lizard-electronics/LizardBot1_ProjectFiles/README.md

# LizardBot1_ProjectFiles
## [In Development...]
Project Files for LizardBot 1 differential-drive ROS2 robot.
ROS2 development repository: https://github.com/lizard-electronics/lizardbot1
