lizard-electronics/LizardBot1_ProjectFiles/4_Docs/LizardBot1_Diagrams_Electrical-Layout.pdf

## Hardware Controller PCB

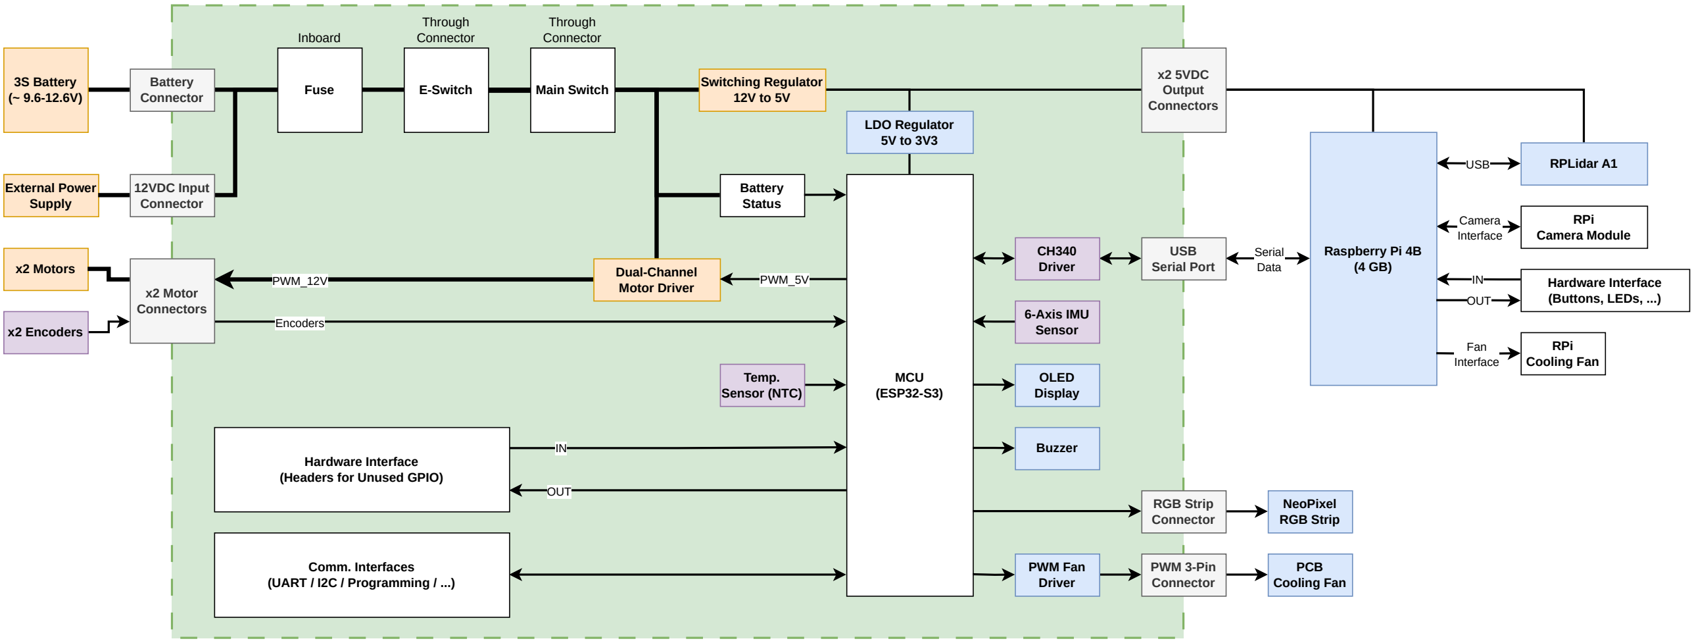
[picture p3: figure]
3S Battery (~ 9.6-12.6V); Switching Regulator; 12V to 5V Fuse; E-Switch; Main Switch; PWM_12V; Dual-Channel Motor Driver; x2 Motors; Encoders; PWM_5V; MCU (ESP32-S3); USB; RPLidar A1; Camera Interface; Raspberry Pi 4B (4 GB); Inboard; Through Connector; Comm. Interfaces (UART / I2C / Programming / ...); OUT; Hardware Interface (Headers for Unused GPIO); RPi Camera Module; Hardware Interface; (Buttons, LEDs, ...); Temp. Sensor (NTC); PCB Cooling Fan; Fan Interface; RPi Cooling Fan; Battery Status; LDO Regulator 5V to 3V3; External Power Supply; x2 Motor Connectors; 12VDC Input Connector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
