lizard-electronics/LizardBot1_ProjectFiles/4_Docs/LizardBot1_ESP32_Pinout.xlsx

Sheet: ESP32_Pinout
PIN | GPIO | INPUT | OUTPUT | ADC | Comments | LizardBot1 Signal Label |  |  | 1 | 38
1 | GND | - | - | - |  |  |  |  | 2 | 37
2 | VDD | - | - | - |  |  |  |  | 3 | 36
3 | EN | - | - | - |  |  |  | MCU_BAT_STATUS | 4 | 35
4 | 36 (VP) | YES | NO | ADC1_0 | Input only GPIO, cannot be configured as output | MCU_BAT_STATUS | ANALOG IN | DRV1_IPROPI | 5 | 34
5 | 39 (VN) | YES | NO | ADC1_3 | Input only GPIO, cannot be configured as output | DRV2_IPROPI | ANALOG IN | DRV1_nFAULT | 6 | 33 | DRV1_nSLEEP
6 | 34 | YES | NO | ADC1_6 | Input only GPIO, cannot be configured as output | DRV1_IPROPI | ANALOG IN | ENC1_A | 7 | 32
7 | 35 | YES | NO | ADC1_7 | Input only GPIO, cannot be configured as output | ENC2_A | ANALOG IN | ENC1_B | 8 | 31 | DRV1_PH_IN2
8 | 32 | YES | YES | ADC1_4 |  | ENC2_B | ANALOG IN | DRV2_IPROPI | 9 | 30 | DRV1_EN_IN1
9 | 33 | YES | YES | ADC1_5 |  | DRV2_nFAULT | ANALOG IN | DRV2_nFAULT | 10 | 29 | MCU_FAN_PWM
10 | 25 | YES | YES | ADC2_8 |  | DRV2_nSLEEP | I/O | ENC2_A | 11 | 28 | DRV2_nSLEEP
11 | 26 | YES | YES | ADC2_9 |  | DRV2_PH_IN2 | I/O | ENC2_B | 12 | 27 | DRV2_PH_IN2
12 | 27 | YES | YES | ADC2_7 |  | DRV2_EN_IN1 | I/O | MCU_BUZZER | 13 | 26 | DRV2_EN_IN1
13 | 14 | YES | YES | ADC2_6 |  | MCU_BUZZER | I/O |  | 14 | 25
14 | 12 (MTDI) | YES (Internal pull-down) | YES | ADC2_5 | Must be LOW during boot | MCU_IO12_RESERVED | O
15 | NC | - | - | -
16 | 13 | YES | YES | ADC2_4 |  | MCU_BUTTON | I/O |  | 1 (GND) | 38 (GND)
17 | 9 (SHD/SD2) | NO | NO | - | Connected to Flash memory |  |  |  | 2 (VDD) | 37 (SCL)
18 | 10 (SWP/SD3) | NO | NO | - | Connected to Flash memory |  |  |  | 3 (EN) | 36 (SDA)
19 | 11 (SCS/CMD) | NO | NO | - | Connected to Flash memory |  |  | MCU_BAT_STATUS | 4 (36) | 35 (TXD)
20 | 6 (SCK/CLK) | NO | NO | - | Connected to Flash memory |  |  | DRV2_IPROPI | 5 (39) | 34 (RXD)
21 | 7 (SDO/SD0) | NO | NO | - | Connected to Flash memory |  |  | DRV1_IPROPI | 6 (34) | 33 (21) | ENC1_B
22 | 8 (SDI/SD1) | NO | NO | - | Connected to Flash memory |  |  | ENC2_A | 7 (35) | 32 (NC)
23 | 15 (MTDO) | YES (Internal pull-up) | YES | ADC2_3 | Must be HIGH during boot, prevents startup log if pulled LOW | MCU_NEOPIXEL | O | ENC2_B | 8 (32) | 31 (19) | ENC1_A
24 | 2 | YES (Internal pull-down) | YES | ADC2_2 | Must be LOW during boot and connected to the on-board LED | MCU_IO2_LED | MCU_IO2_LED | DRV2_nFAULT | 9 (33) | 30 (18) | DRV1_EN_IN1
25 | 0 | YES (Internal pull-up) | YES | ADC2_1 | Must be HIGH during boot and LOW for programming | MCU_IO0 | MCU_IO0 | DRV2_nSLEEP | 10 (25) | 29 (5) | MCU_FAN_PWM
26 | 4 | YES | YES | ADC2_0 |  | DRV1_nFAULT | I/O | DRV2_PH_IN2 | 11 (26) | 28 (17) | DRV1_PH_IN2
27 | 16 | YES | YES | - |  | DRV1_nSLEEP | I/O | DRV2_EN_IN1 | 12 (27) | 27 (16) | DRV1_nSLEEP
28 | 17 | YES | YES | - |  | DRV1_PH_IN2 | I/O | MCU_BUZZER | 13 (14) | 26 (4) | DRV1_nFAULT
29 | 5 | YES | YES | - | Must be HIGH during boot | MCU_FAN_PWM | O |  | 14 (12) | 25 (0)
30 | 18 | YES | YES | - |  | DRV1_EN_IN1 | I/O
31 | 19 | YES | YES | - |  | ENC1_A | I/O
32 | NC | - | - | -
33 | 21 | YES | YES | - |  | ENC1_B | I/O
34 | 3 (RXD0) | YES | NO | - | Rx pin, used for flashing and debugging | MCU_RXD0 | RX
35 | 1 (TXD0) | NO | YES | - | Tx pin, used for flashing and debugging | MCU_TXD0 | TX
36 | 22 | YES | YES | - | I2C Communication | MCU_SDA | I/O
37 | 23 | YES | YES | - | I2C Communication | MCU_SCL | I/O
38 | GND | - | - | -

Sheet: ControlBoard_SignalList
AIN | MCU_BAT_STATUS
OUT | DRV1_EN_IN1
OUT | DRV1_PH_IN2
OUT | DRV1_nSLEEP
AIN | DRV1_IPROPI
IN | DRV1_nFAULT
IN | ENC1_A
IN | ENC1_B
OUT | DRV2_EN_IN1
OUT | DRV2_PH_IN2
OUT | DRV2_nSLEEP
AIN | DRV2_IPROPI
IN | DRV2_nFAULT
IN | ENC2_A
IN | ENC2_B
