lizard-electronics/LizardBot1_ProjectFiles/1_Hardware/PCB/LizardBot1_ControlBoard_v1/pcb_images/LizardBot1_ControlBoard_v1_all-layers2.png

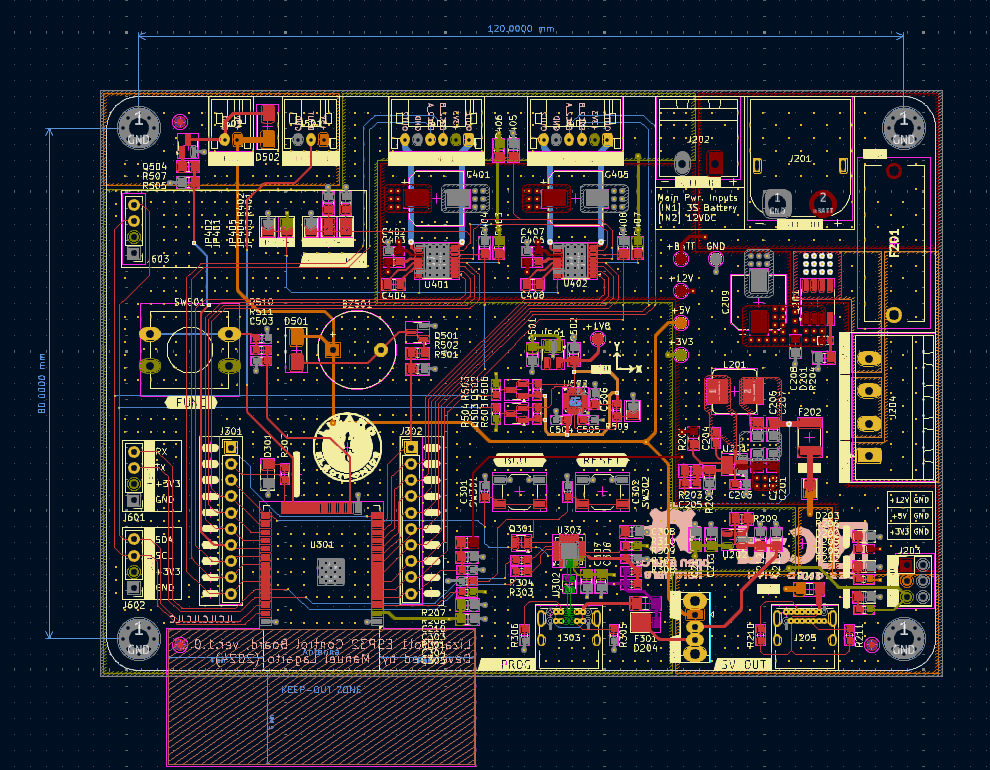
1_Hardware/PCB/LizardBot1_ControlBoard_v1/pcb_images/LizardBot1_ControlBoard_v1_all-layers2.png
