lizard-electronics/LizardBot1_ProjectFiles/1_Hardware/PCB/LizardBot1_ControlBoard_v1/pcb_images/LizardBot1_ControlBoard_v1_b-copper.png

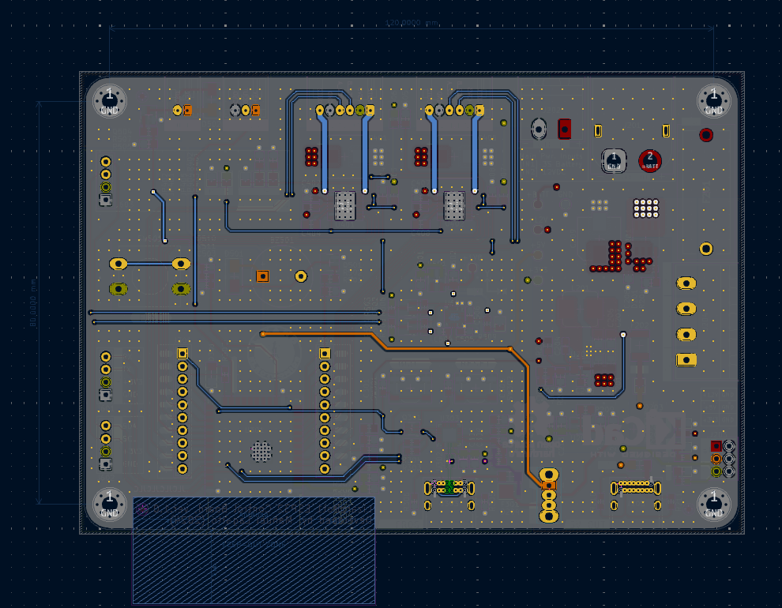
1_Hardware/PCB/LizardBot1_ControlBoard_v1/pcb_images/LizardBot1_ControlBoard_v1_b-copper.png
