lizard-electronics/LizardBot1_ProjectFiles/4_Docs/LizardBot1_ControlBoard_BOM.xlsx

Sheet: BOM
Reference | Value | Datasheet | Footprint | Qty | Part Number | Order | Distribuitor URL | Comments
BZ501 | Buzzer | ~ | Buzzer_Beeper:Buzzer_12x9.5RM7.6 | 1 | C7428406 | YES | https://www.lcsc.com/product-detail/Buzzers_S-S-SEA-12095-0540-42-40P6-5_C7428406.html
C201,C206,C207,C208,C304 | 22uF | ~ | Capacitor_SMD:C_0805_2012Metric_Pad1.18x1.45mm_HandSolder | 5 | C45783 | NO
C202,C212,C305,C307,C308 | 0.1uF | ~ | Capacitor_SMD:C_0805_2012Metric_Pad1.18x1.45mm_HandSolder | 5 | C49678 | NO
C203,C204,C210,C301,C302,C303,C402,C403,C406,C407,C503,C504,C505,C506 | 0.1uF | ~ | Capacitor_SMD:C_0603_1608Metric_Pad1.08x0.95mm_HandSolder | 14 | C14663 | NO
C205 | 33pF | ~ | Capacitor_SMD:C_0603_1608Metric_Pad1.08x0.95mm_HandSolder | 1 | C91368 | YES | https://www.lcsc.com/product-detail/Multilayer-Ceramic-Capacitors-MLCC-SMD-SMT_FH-Guangdong-Fenghua-Advanced-Tech-0603CG330J500NT_C91368.html
C209 | 470uF | ~ | Capacitor_SMD:CP_Elec_8x10 | 1 | C4747956 | YES | https://www.lcsc.com/product-detail/Aluminum-Electrolytic-Capacitors-SMD_KNSCHA-RST470UF25V032_C4747956.html
C211,C213,C214,C306,C501,C502 | 4.7uF | ~ | Capacitor_SMD:C_0805_2012Metric_Pad1.18x1.45mm_HandSolder | 6 | C1779 | NO
C401,C405 | 220uF | ~ | Capacitor_SMD:CP_Elec_8x10 | 2 | C4747976 | YES | https://www.lcsc.com/product-detail/Aluminum-Electrolytic-Capacitors-SMD_KNSCHA-RST220UF35V022_C4747976.html
C404,C408 | 22nF | ~ | Capacitor_SMD:C_0805_2012Metric_Pad1.18x1.45mm_HandSolder | 2 | C51574 | YES | https://www.lcsc.com/product-detail/Multilayer-Ceramic-Capacitors-MLCC-SMD-SMT_FH-Guangdong-Fenghua-Advanced-Tech-0805B223K500NT_C51574.html
D201 | BZT52C12T | https://pt.mouser.com/datasheet/2/115/DIOD_S_A0004048695_1-2542541.pdf | Diode_SMD:D_SOD-523 | 1 | C507911 | YES | https://www.lcsc.com/product-detail/Zener-Diodes_Diodes-Incorporated-BZT52C12T-7_C507911.html
D202,D203,D205 | Green | ~ | LED_SMD:LED_0805_2012Metric_Pad1.15x1.40mm_HandSolder | 3 | C965815 | NO
D204 | SS1P3L | https://www.vishay.com/docs/88915/ss1p3l.pdf | Diode_SMD:D_SMP_DO-220AA | 1 | C2875475 | YES | https://www.lcsc.com/product-detail/Schottky-Diodes_Vishay-Intertech-SS1P3L-M3-84A_C2875475.html
D301 | Red | ~ | LED_SMD:LED_1206_3216Metric_Pad1.42x1.75mm_HandSolder | 1 | C499461 | NO
D501,D502 | SS14 | https://www.vishay.com/docs/88746/ss12.pdf | Diode_SMD:D_SMA | 2 | C2480 | NO
F201 | 10A | https://pt.mouser.com/datasheet/2/240/media-3322743.pdf | Fuse:Fuseholder_Clip-5x20mm_Littelfuse_519_Inline_P20.60x5.00mm_D1.00mm_Horizontal | 1 | C2760101 | YES | https://www.lcsc.com/product-detail/Fuseholders_Littelfuse-0PTF0078P_C2760101.html | No stock at LCSC. Mouser: 576-0PTF0078P
F201-1 |  |  | - |  | C5299837 |  | https://www.lcsc.com/product-detail/Fuseholders_Littelfuse-00BS0232P_C5299837.html | Low stock at LCSC. Mouser: 576-00BS0232P
F201-2 |  |  | - |  | C3166596 |  | https://www.lcsc.com/product-detail/Fuses_Littelfuse-0234010-MXP_C3166596.html | No stock at LCSC. Mouser: 0234010.MXP
F202 | 5A | https://pt.mouser.com/datasheet/2/240/media-3323076.pdf | Fuse:Fuse_1812_4532Metric_Pad1.30x3.40mm_HandSolder | 1 | C127824 | YES | https://www.lcsc.com/product-detail/Resettable-Fuses_Littelfuse-1812L300MR_C127824.html
F203 | 3A | https://pt.mouser.com/datasheet/2/240/media-3319932.pdf | Fuse:Fuse_1206_3216Metric_Pad1.42x1.75mm_HandSolder | 1 | C118413 | YES | https://www.lcsc.com/product-detail/Resettable-Fuses_Littelfuse-1206L150THWR_C118413.html
F301 | 500mA | ~ | Fuse:Fuse_1206_3216Metric_Pad1.42x1.75mm_HandSolder | 1 | C163512 | NO
J201 | XT60PW-M | https://www.lcsc.com/datasheet/lcsc_datasheet_1810251322_Changzhou-Amass-Elec-XT60_C98733.pdf | Connector_AMASS:AMASS_XT60PW-M_1x02_P7.20mm_Horizontal | 1 | C98732 | YES | https://www.lcsc.com/product-detail/plug_Changzhou-Amass-Elec-XT60PW-M_C98732.html
J202 | WJ2EDGR-5.08-2P | https://www.lcsc.com/datasheet/lcsc_datasheet_1912251632_Ningbo-Kangnex-Elec-WJ2EDGR-5-08-2P_C8383.pdf | Connector_Phoenix_MSTB:PhoenixContact_MSTBA_2,5_2-G-5,08_1x02_P5.08mm_Horizontal | 1 | C8383 | YES | https://www.lcsc.com/product-detail/Pluggable-System-Terminal-Block_Ningbo-Kangnex-Elec-WJ2EDGR-5-08-2P_C8383.html
J202-1 | WJ2EDGK-5.08-2P |  | - |  | C71370 |  | https://www.lcsc.com/product-detail/Pluggable-System-Terminal-Block_Ningbo-Kangnex-Elec-WJ2EDGK-5-08-2P_C71370.html
J203 | 2.54mm 2x3 (M) |  | Connector_PinHeader_2.54mm:PinHeader_2x03_P2.54mm_Vertical |  | C65114 | NO
J502 | JST-S2B-PH-K-S(LF)(SN) | ~ | Connector_JST:JST_PH_S2B-PH-K_1x02_P2.00mm_Horizontal | 1 | C173752 | YES | https://www.lcsc.com/product-detail/Wire-To-Board-Connector_JST-S2B-PH-K-S-LF-SN_C173752.html
J502-1 | JST-PHR-2 |  | - |  | C3195190 |  | https://www.lcsc.com/product-detail/Housings-Wire-To-Board-Wire-To-Wire_JST-PHR-2_C3195190.html
J205 | WJ2EDGR-5.08-4P | https://www.lcsc.com/datasheet/lcsc_datasheet_2304140030_Ningbo-Kangnex-Elec-WJ2EDGR-5-08-4P_C8443.pdf | Connector_Phoenix_MSTB:PhoenixContact_MSTBA_2,5_4-G-5,08_1x04_P5.08mm_Horizontal | 1 | C8443 | YES | https://www.lcsc.com/product-detail/Pluggable-System-Terminal-Block_Ningbo-Kangnex-Elec-WJ2EDGR-5-08-4P_C8443.html
J205-1 | WJ2EDGK-5.08-4P |  | - |  | C71372 |  | https://www.lcsc.com/product-detail/Pluggable-System-Terminal-Block_Ningbo-Kangnex-Elec-WJ2EDGK-5-08-4P_C71372.html
J207 | USB_C_Receptacle_PowerOnly_6P | https://www.usb.org/sites/default/files/documents/usb_type-c.zip | Connector_USB:USB_C_Receptacle_GCT_USB4085 | 1 | C7095263 | YES | https://www.lcsc.com/product-detail/span-style-background-color-ff0-USB-span-Connectors_Global-Connector-Technology-USB4085-GF-A_C7095263.html | No stock at LCSC. Mouser: 640-USB4085-GF-A
J301,J302 | 2.54mm (F) | ~ | Connector_PinHeader_2.54mm:PinHeader_1x10_P2.54mm_Vertical | 2 | NA | NO
J303 | USB_C_Receptacle_USB2.0_16P | https://www.usb.org/sites/default/files/documents/usb_type-c.zip | Connector_USB:USB_C_Receptacle_GCT_USB4085 | 1 | C7095263 | YES | https://www.lcsc.com/product-detail/span-style-background-color-ff0-USB-span-Connectors_Global-Connector-Technology-USB4085-GF-A_C7095263.html | No stock at LCSC. Mouser: 640-USB4085-GF-A
J401,J402 | JST-S6B-PH-K-S(LF)(SN) | ~ | Connector_JST:JST_PH_S6B-PH-K_1x06_P2.00mm_Horizontal | 2 | C157920 | NO
J501 | JST-S3B-PH-K-S(LF)(SN) | ~ | Connector_JST:JST_PH_S3B-PH-K_1x03_P2.00mm_Horizontal | 1 | C157929 | YES | https://www.lcsc.com/product-detail/Wire-To-Board-Connector_JST-S3B-PH-K-S-LF-SN_C157929.html
J501-1 | JST-PHR-3 |  | - |  | C265393 |  | https://www.lcsc.com/product-detail/Housings-Wire-To-Board-Wire-To-Wire_JST-PHR-3_C265393.html
J601,J602,J603 | 2.54mm (F) | ~ | Connector_PinHeader_2.54mm:PinHeader_1x04_P2.54mm_Vertical | 3 | NA | NO
L201 | 4.7uH | https://pt.mouser.com/datasheet/2/54/BOURNS_SRP7028AA-2064300.pdf | Inductor_SMD:L_Bourns_SRP7028A_7.3x6.6mm | 1 | C840529 | YES | https://www.lcsc.com/product-detail/Power-Inductors_BOURNS-SRP7028A-4R7M_C840529.html
Q201 | SQ4425EY | https://ngspice.sourceforge.io/docs/ngspice-html-manual/manual.xhtml#cha_MOSFETs | Package_SO:SO-8_3.9x4.9mm_P1.27mm | 1 | C6495636 | YES | https://www.lcsc.com/product-detail/MOSFETs_Vishay-Intertech-SQ4425EY-T1_GE3_C6495636.html
Q301 | UMH3N | http://rohmfs.rohm.com/en/products/databook/datasheet/discrete/transistor/digital/emh3t2r-e.pdf | Package_TO_SOT_SMD:SOT-363_SC-70-6 | 1 | C123008 | YES | https://www.lcsc.com/product-detail/Digital-Transistors_ROHM-Semicon-UMH3NTN_C123008.html
Q501,Q504 | AO3400A | http://www.aosmd.com/pdfs/datasheet/AO3400A.pdf | Package_TO_SOT_SMD:SOT-23 | 2 | C700953 | NO
Q502,Q503 | BSS138 | https://www.onsemi.com/pub/Collateral/BSS138-D.PDF | Package_TO_SOT_SMD:SOT-23 | 2 | C7420339 | YES | https://www.lcsc.com/product-detail/MOSFETs_hongjiacheng-BSS138_C7420339.html
R201,R209 | 100k | ~ | Resistor_SMD:R_0805_2012Metric_Pad1.20x1.40mm_HandSolder | 2 | C149504 | NO
R202 | 5.49k | ~ | Resistor_SMD:R_0805_2012Metric_Pad1.20x1.40mm_HandSolder | 1 | C17726 | YES | https://www.lcsc.com/product-detail/Chip-Resistor-Surface-Mount_UNI-ROYAL-Uniroyal-Elec-0805W8F5491T5E_C17726.html
R203 | 40.2k | ~ | Resistor_SMD:R_0805_2012Metric_Pad1.20x1.40mm_HandSolder | 1 | C17678 | YES | https://www.lcsc.com/product-detail/Chip-Resistor-Surface-Mount_UNI-ROYAL-Uniroyal-Elec-0805W8F4022T5E_C17678.html
R204,R207,R403,R407,R501,R505 | 10k | ~ | Resistor_SMD:R_0805_2012Metric_Pad1.20x1.40mm_HandSolder | 6 | C17414 | YES | https://www.lcsc.com/product-detail/Chip-Resistor-Surface-Mount_UNI-ROYAL-Uniroyal-Elec-0805W8F1002T5E_C17414.html
R205,R206,R302,R310 | 1k | ~ | Resistor_SMD:R_0603_1608Metric_Pad0.98x0.95mm_HandSolder | 4 | C2907002 | NO
R208 | 3.3k | ~ | Resistor_SMD:R_0805_2012Metric_Pad1.20x1.40mm_HandSolder | 1 | C26010 | YES | https://www.lcsc.com/product-detail/Chip-Resistor-Surface-Mount_UNI-ROYAL-Uniroyal-Elec-0805W8F3301T5E_C26010.html
R210,R211,R301,R503,R504,R506,R508,R509,R510 | 10k | ~ | Resistor_SMD:R_0603_1608Metric_Pad0.98x0.95mm_HandSolder | 9 | C98220 | NO
R212,R511 | 470 | ~ | Resistor_SMD:R_0603_1608Metric_Pad0.98x0.95mm_HandSolder | 2 | C2907041 | NO
R305,R306 | 5k1 | ~ | Resistor_SMD:R_0603_1608Metric_Pad0.98x0.95mm_HandSolder | 2 | C23186 | YES | https://www.lcsc.com/product-detail/Chip-Resistor-Surface-Mount_UNI-ROYAL-Uniroyal-Elec-0603WAF5101T5E_C23186.html
R307,R308,R309 | 47k | ~ | Resistor_SMD:R_0603_1608Metric_Pad0.98x0.95mm_HandSolder | 3 | C2907042 | NO
R401 | 62k | ~ | Resistor_SMD:R_0805_2012Metric_Pad1.20x1.40mm_HandSolder | 1 | C17783 | YES | https://www.lcsc.com/product-detail/Chip-Resistor-Surface-Mount_UNI-ROYAL-Uniroyal-Elec-0805W8F6202T5E_C17783.html
R402 | 20k | ~ | Resistor_SMD:R_0805_2012Metric_Pad1.20x1.40mm_HandSolder | 1 | C2907240 | NO
R404,R408 | 1.2k | ~ | Resistor_SMD:R_0805_2012Metric_Pad1.20x1.40mm_HandSolder | 2 | C17379 | YES | https://www.lcsc.com/product-detail/Chip-Resistor-Surface-Mount_UNI-ROYAL-Uniroyal-Elec-0805W8F1201T5E_C17379.html
R405 | 16k | ~ | Resistor_SMD:R_0805_2012Metric_Pad1.20x1.40mm_HandSolder | 1 | C17490 | YES | https://www.lcsc.com/product-detail/Chip-Resistor-Surface-Mount_UNI-ROYAL-Uniroyal-Elec-0805W8F1602T5E_C17490.html
R406 | 50k | ~ | Resistor_SMD:R_0805_2012Metric_Pad1.20x1.40mm_HandSolder | 1 | C2828840 | YES | https://www.lcsc.com/product-detail/Chip-Resistor-Surface-Mount_Viking-Tech-ARG05DTC5002_C2828840.html
R502,R507 | 150 | ~ | Resistor_SMD:R_0805_2012Metric_Pad1.20x1.40mm_HandSolder | 2 | C17471 | NO
SW201 | SW_SPDT | ~ | Button_Switch_THT:SW_Slide_SPDT_Straight_CK_OS102011MS2Q | 1 | C2800116 | NO
SW301,SW302 | SW_Push | ~ | Button_Switch_SMD:SW_SPST_TL3342 | 2 | C2886894 | NO
SW501 | SW_Push | ~ | Button_Switch_THT:SW_PUSH-12mm | 1 | C455206 | NO
U201 | MP2225 | https://www.monolithicpower.com/en/documentview/productdocument/index/version/2/document_type/Datasheet/lang/en/sku/MP2225GJ-Z | Package_TO_SOT_SMD:SOT-23-8 | 1 | 946-MP2225GJ-Z | YES | https://pt.mouser.com/ProductDetail/Monolithic-Power-Systems-MPS/MP2225GJ-Z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 | Discontinued at LCSC! Mouser: 946-MP2225GJ-Z
U202 | AP2112K-3.3 | https://www.diodes.com/assets/Datasheets/AP2112.pdf | Package_TO_SOT_SMD:SOT-23-5 | 1 | C51118 | YES | https://www.lcsc.com/product-detail/Voltage-Regulators-Linear-Low-Drop-Out-LDO-Regulators_Diodes-Incorporated-AP2112K-3-3TRG1_C51118.html
U301 | ESP32-WROOM-32E | https://www.espressif.com/sites/default/files/documentation/esp32-wroom-32e_esp32-wroom-32ue_datasheet_en.pdf | RF_Module:ESP32-WROOM-32D | 1 | 356-ESP32WRM32E164PH | YES | https://pt.mouser.com/ProductDetail/Espressif-Systems/ESP32-WROOM-32E-N8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 | More expensive from LCSC. Order from Mouser: 356-ESP32WRM32E164PH
U302 | USBLC6-2P6 | https://www.st.com/resource/en/datasheet/usblc6-2.pdf | Package_TO_SOT_SMD:SOT-666 | 1 | C2827693 | YES | https://www.lcsc.com/product-detail/ESD-and-Surge-Protection-TVS-ESD_TECH-PUBLIC-USBLC6-2P6_C2827693.html
U303 | CP2102N-Axx-xQFN24 | https://www.silabs.com/documents/public/data-sheets/cp2102n-datasheet.pdf | Package_DFN_QFN:QFN-24-1EP_4x4mm_P0.5mm_EP2.6x2.6mm | 1 | C969151 | YES | https://www.lcsc.com/product-detail/USB-Converters_SKYWORKS-SILICON-LABS-CP2102N-A02-GQFN24R_C969151.html | Order in PCBA
U401,U402 | DRV8874 | https://www.ti.com/lit/ds/symlink/drv8874.pdf?ts=1718834450917 | Package_SO:HTSSOP-16-1EP_4.4x5mm_P0.65mm_EP3.4x5mm_Mask3x3mm_ThermalVias | 2 | C1855818 | YES | https://www.lcsc.com/product-detail/Brushed-DC-Motor-Drivers_Texas-Instruments-DRV8874PWPR_C1855818.html
U501 | MIC5225 | https://pt.mouser.com/datasheet/2/268/MIC5225_Ultra_Low_Quiescent_Current_150mA_MicroCap-3441824.pdf | Package_TO_SOT_SMD:SOT-23-5_HandSoldering | 1 | C510894 | YES | https://www.lcsc.com/product-detail/Voltage-Regulators-Linear-Low-Drop-Out-LDO-Regulators_Microchip-Tech-MIC5225-3-0YM5-TR_C510894.html | No stock at LCSC. Mouser: 998-MIC5225-1.8YM5TR
U502 | ICM-20948 | http://www.invensense.com/wp-content/uploads/2016/06/DS-000189-ICM-20948-v1.3.pdf | Sensor_Motion:InvenSense_QFN-24_3x3mm_P0.4mm | 1 | C726001 | YES | https://www.lcsc.com/product-detail/Attitude-Sensors-Gyroscope_TDK-InvenSense-ICM-20948_C726001.html | Order in PCBA
Total: |  |  |  | 122

Sheet: Quote
Store | Products | Price | Order | Comments | Total | 350.30 €
JLCPCB | PCB & Assembly | 105.51 € | 2024-08-09 | Arrival in 12-15 business days. | Original Balance | 3253.95 €
LCSC | PCB Parts | 43.72 € | 2024-08-09 | Arrival in 7-15 business days. | Balance | 2903.65 €
Mouser | PCB Parts & Lidar & Raspberry Kit | 102.14 € | 2024-08-16 | Arrival in 2-3 business days.
Mauser | Raspberry Pi 4B 4GB Kit | 77.91 € | 2024-08-16 | Arrival in 2-3 business days.
Amazon | Motors | 21.02 € | 2024-08-16 | Arrival in 2-3 business days.
 | Battery & Charger
