lizard-electronics/LizardBot1_ProjectFiles/1_Hardware/PCB/LizardBot1_ControlBoard_v1/Project_3DModels/Bourns_SRP7028AA.STEP

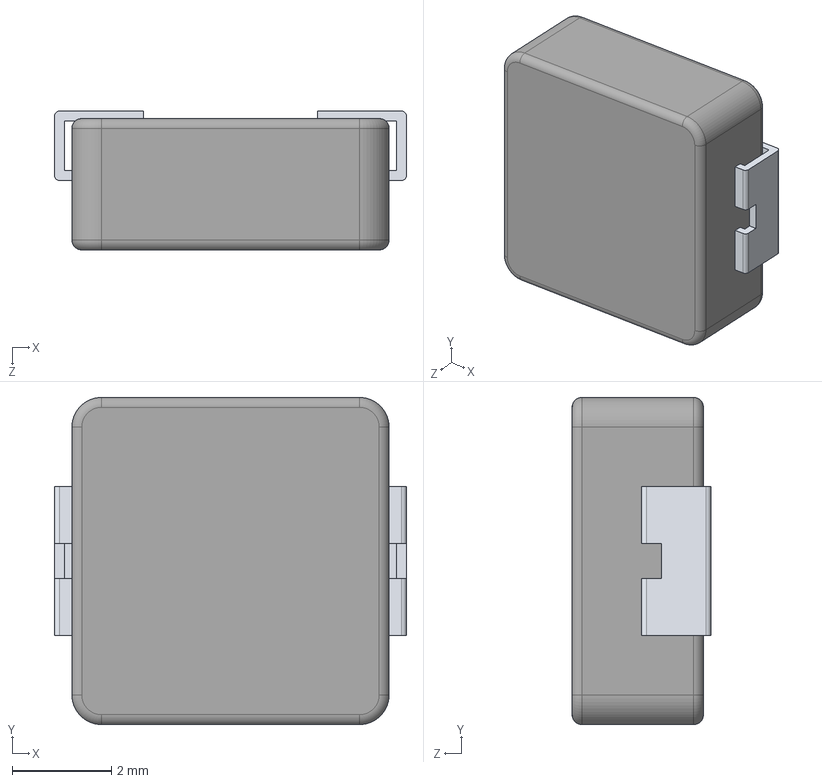
[picture p12: CAD file, 2024-07-31]
1_Hardware/PCB/LizardBot1_ControlBoard_v1/Project_3DModels/Bourns_SRP7028AA.STEP
7.10 x 6.60 x 2.80 mm
Body.STEP
Pin1.STEP
Pin2.STEP
