lizard-electronics/LizardBot1_ProjectFiles/1_Hardware/PCB/LizardBot1_ControlBoard_v1/Project_3DModels/XT60PW-M.STEP

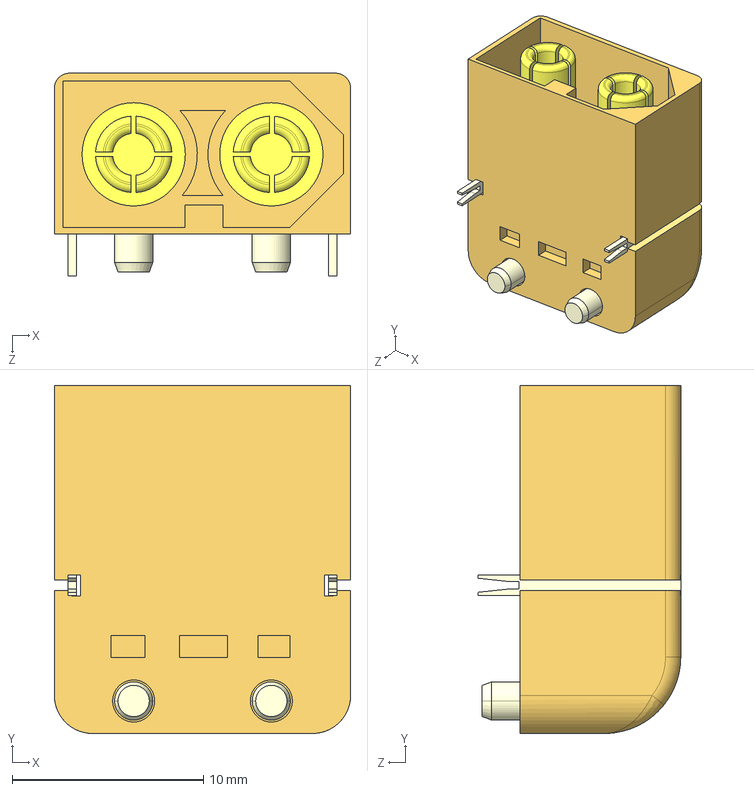
[picture p13: CAD file, 2024-07-31]
1_Hardware/PCB/LizardBot1_ControlBoard_v1/Project_3DModels/XT60PW-M.STEP
15.5 x 18.2 x 10.6 mm
