lizard-electronics/LizardBot1_ProjectFiles/1_Hardware/PCB/LizardBot1_ControlBoard_v1/Project_3DModels/LittelFuse_0PTF0078P.stp

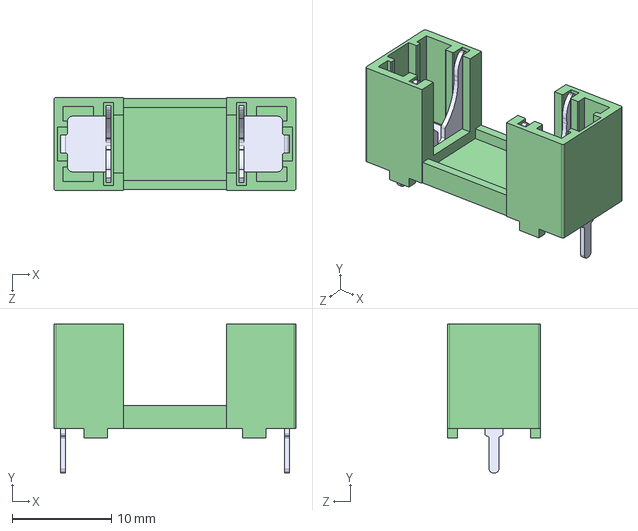
[picture p14: CAD file, 2024-07-31]
1_Hardware/PCB/LizardBot1_ControlBoard_v1/Project_3DModels/LittelFuse_0PTF0078P.stp
24.4 x 15.0 x 9.40 mm
