lizard-electronics/LizardBot1_ProjectFiles/1_Hardware/PCB/LizardBot1_ControlBoard_v1/Project_3DModels/SW_Push_12mm.STEP

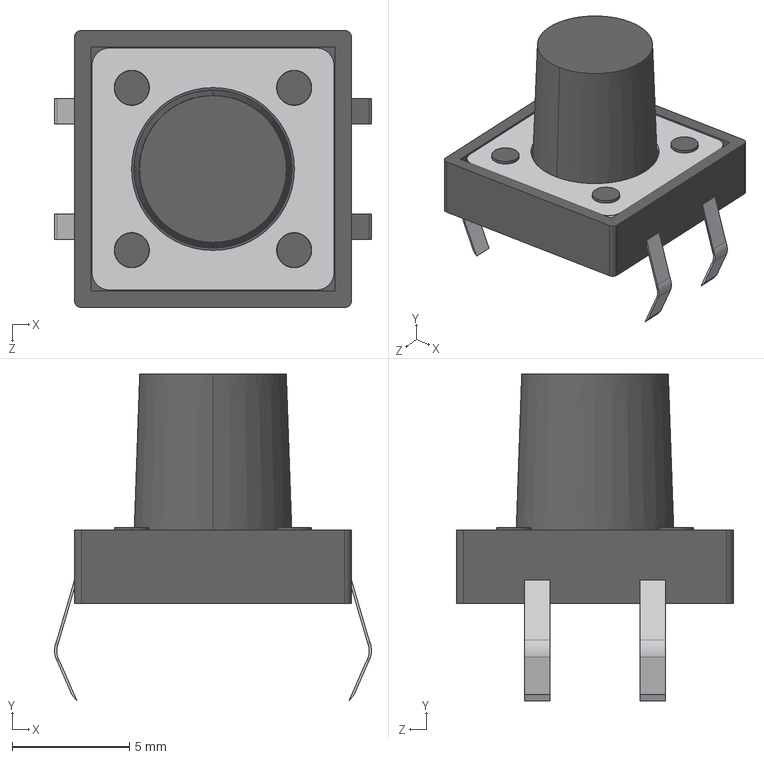
[picture p15: CAD file, 2024-07-31]
1_Hardware/PCB/LizardBot1_ControlBoard_v1/Project_3DModels/SW_Push_12mm.STEP
13.5 x 14.0 x 11.8 mm
