lizard-electronics/LizardBot1_ProjectFiles/1_Hardware/PCB/LizardBot1_ControlBoard_v1/Project_3DModels/Fuse_1812.STEP

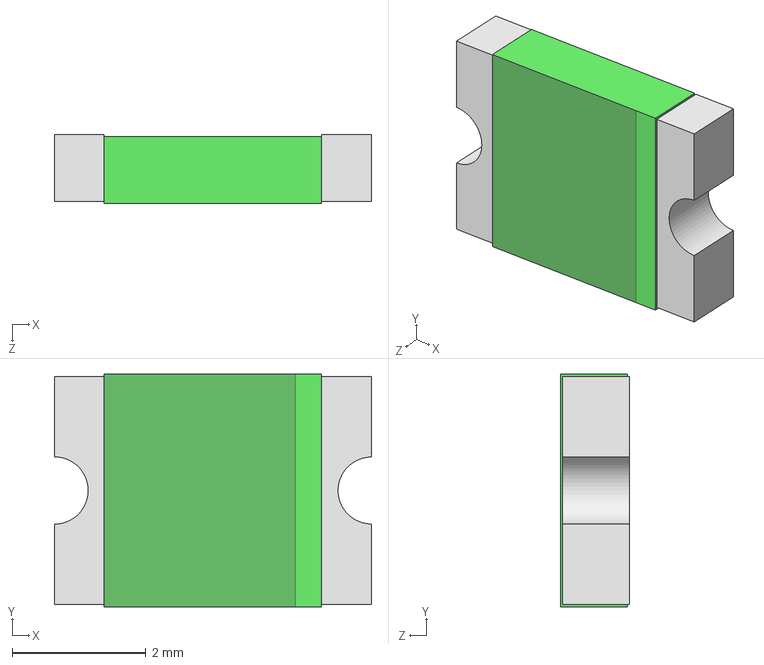
[picture p16: CAD file, 2024-07-31]
1_Hardware/PCB/LizardBot1_ControlBoard_v1/Project_3DModels/Fuse_1812.STEP
4.74 x 3.48 x 1.04 mm
