lizard-electronics/LizardBot1_ProjectFiles/1_Hardware/LizardBot1_ControlBoard_Schematic_v1.pdf

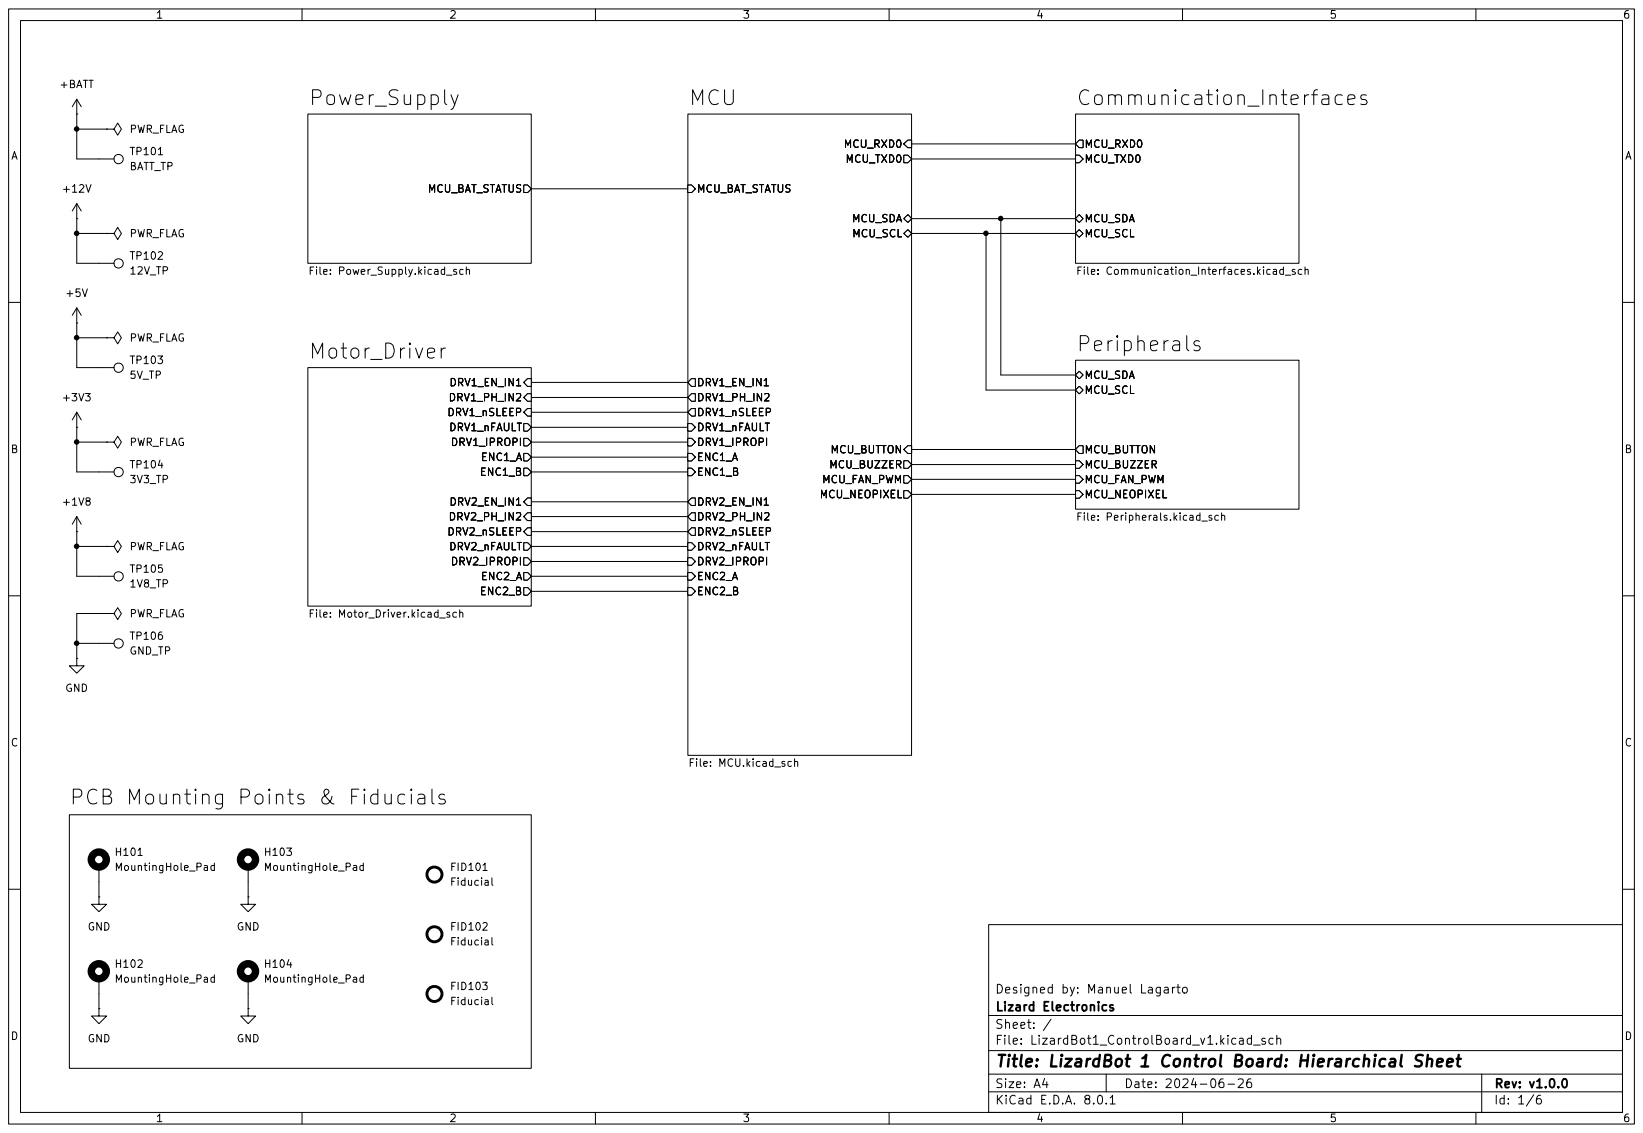
[picture p17: page 1]

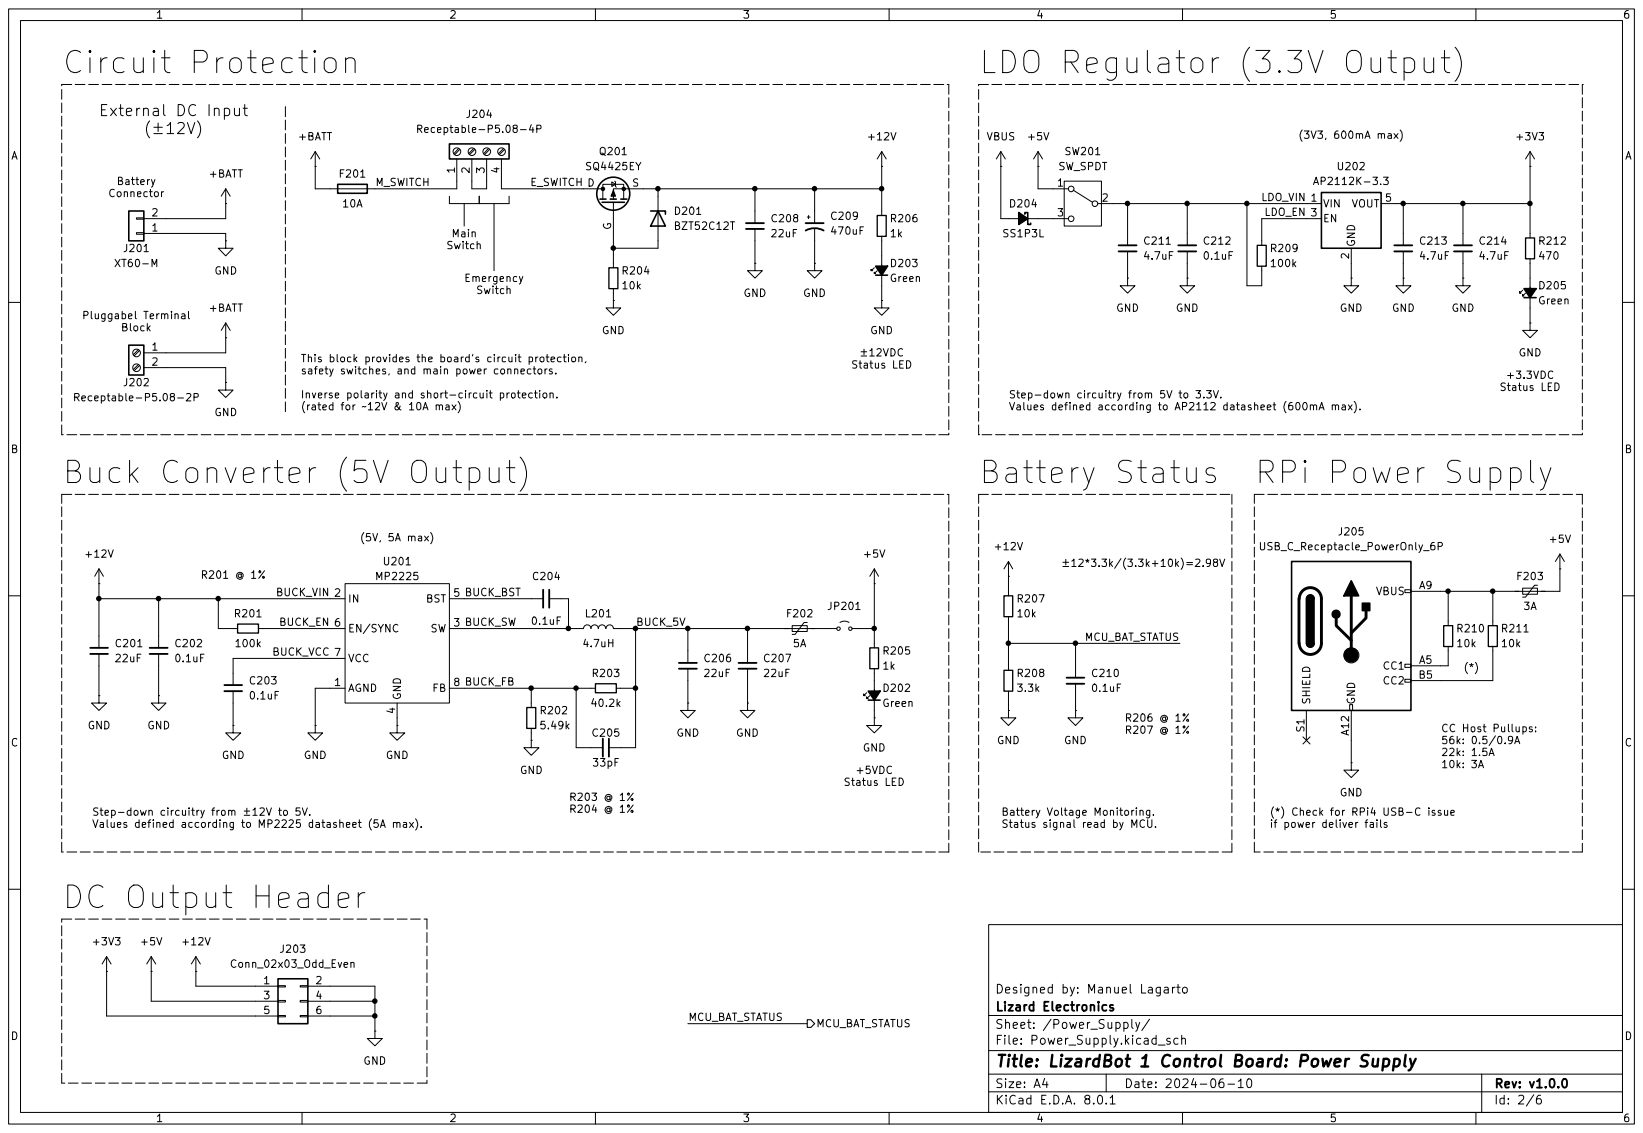
[picture p18: page 2]

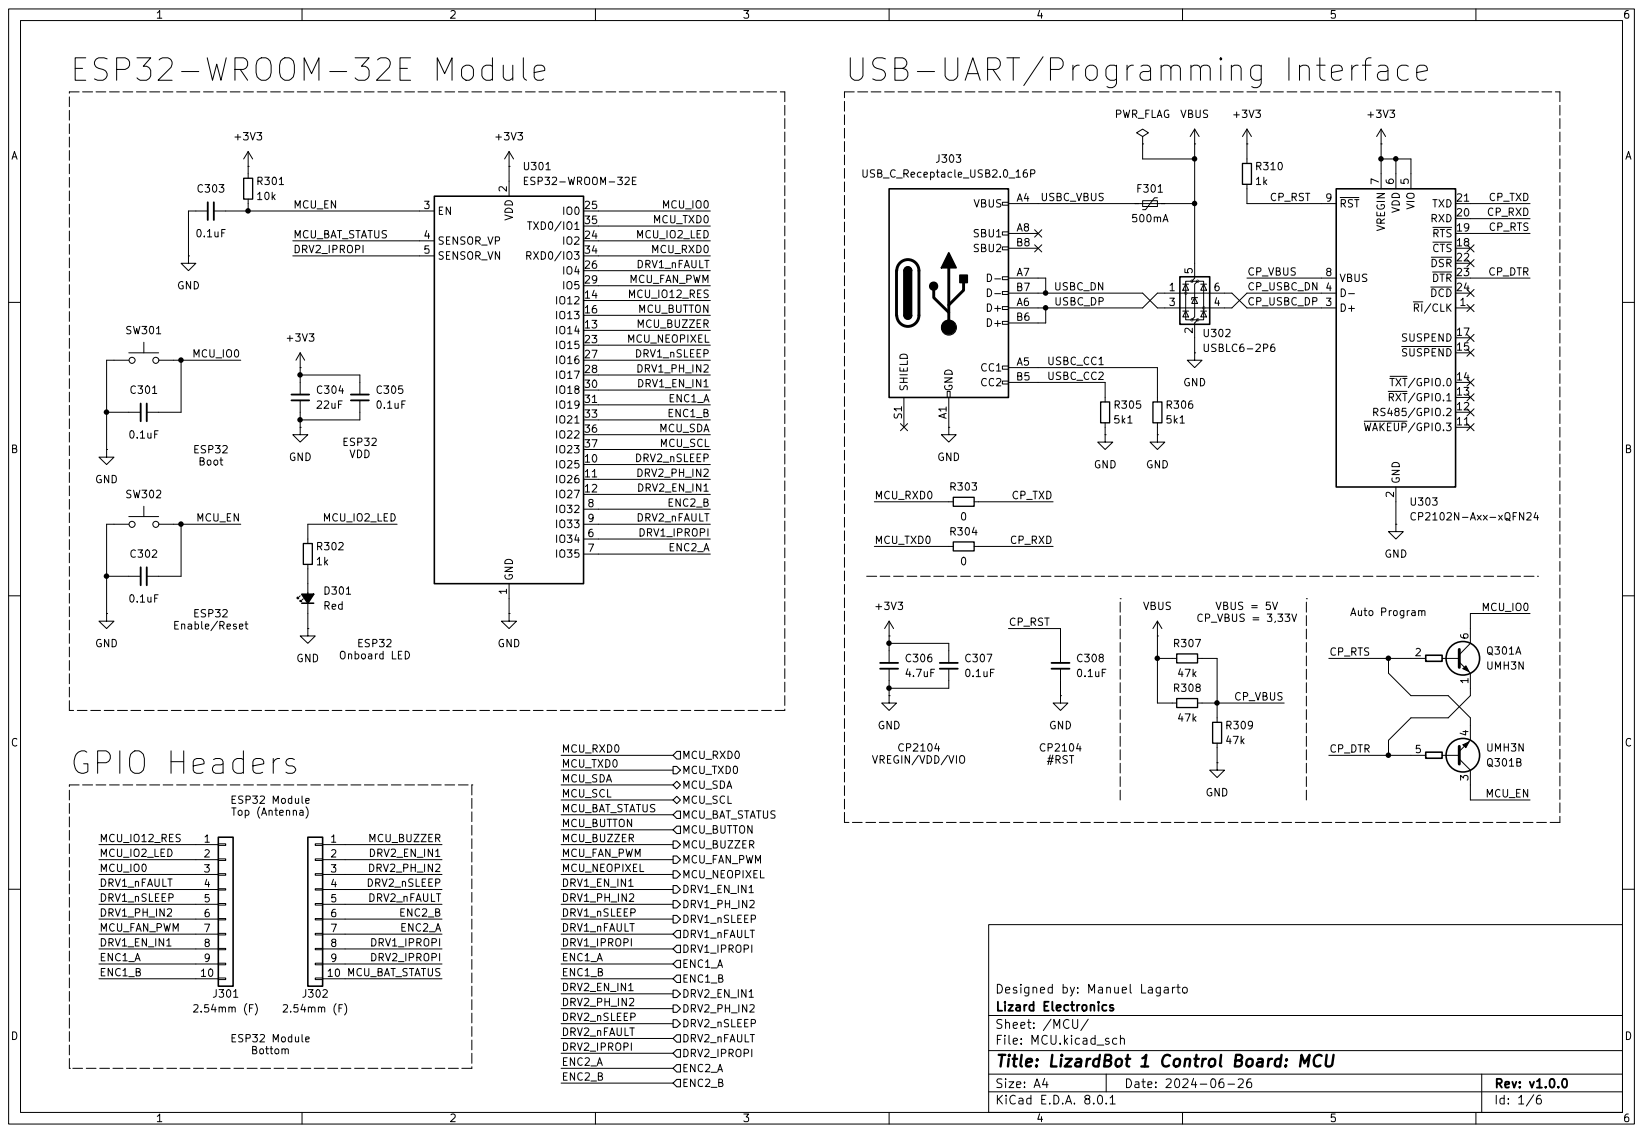
[picture p19: page 3]

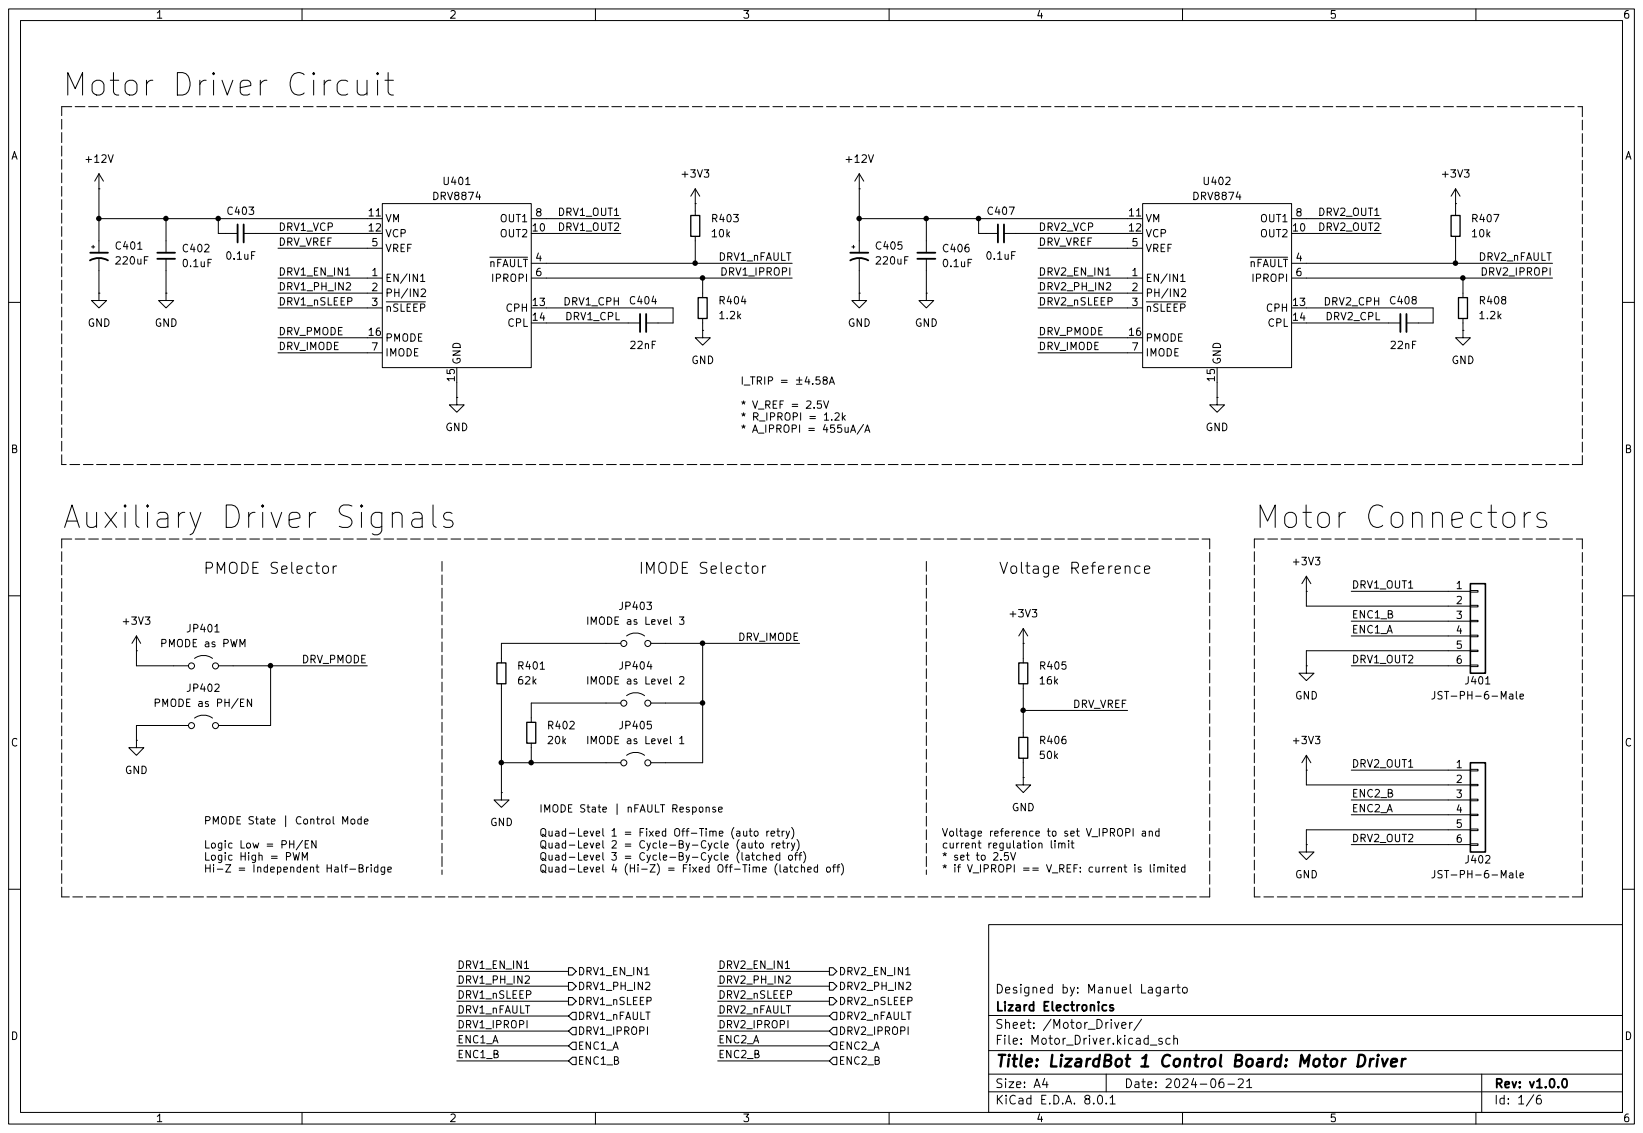
[picture p20: page 4]

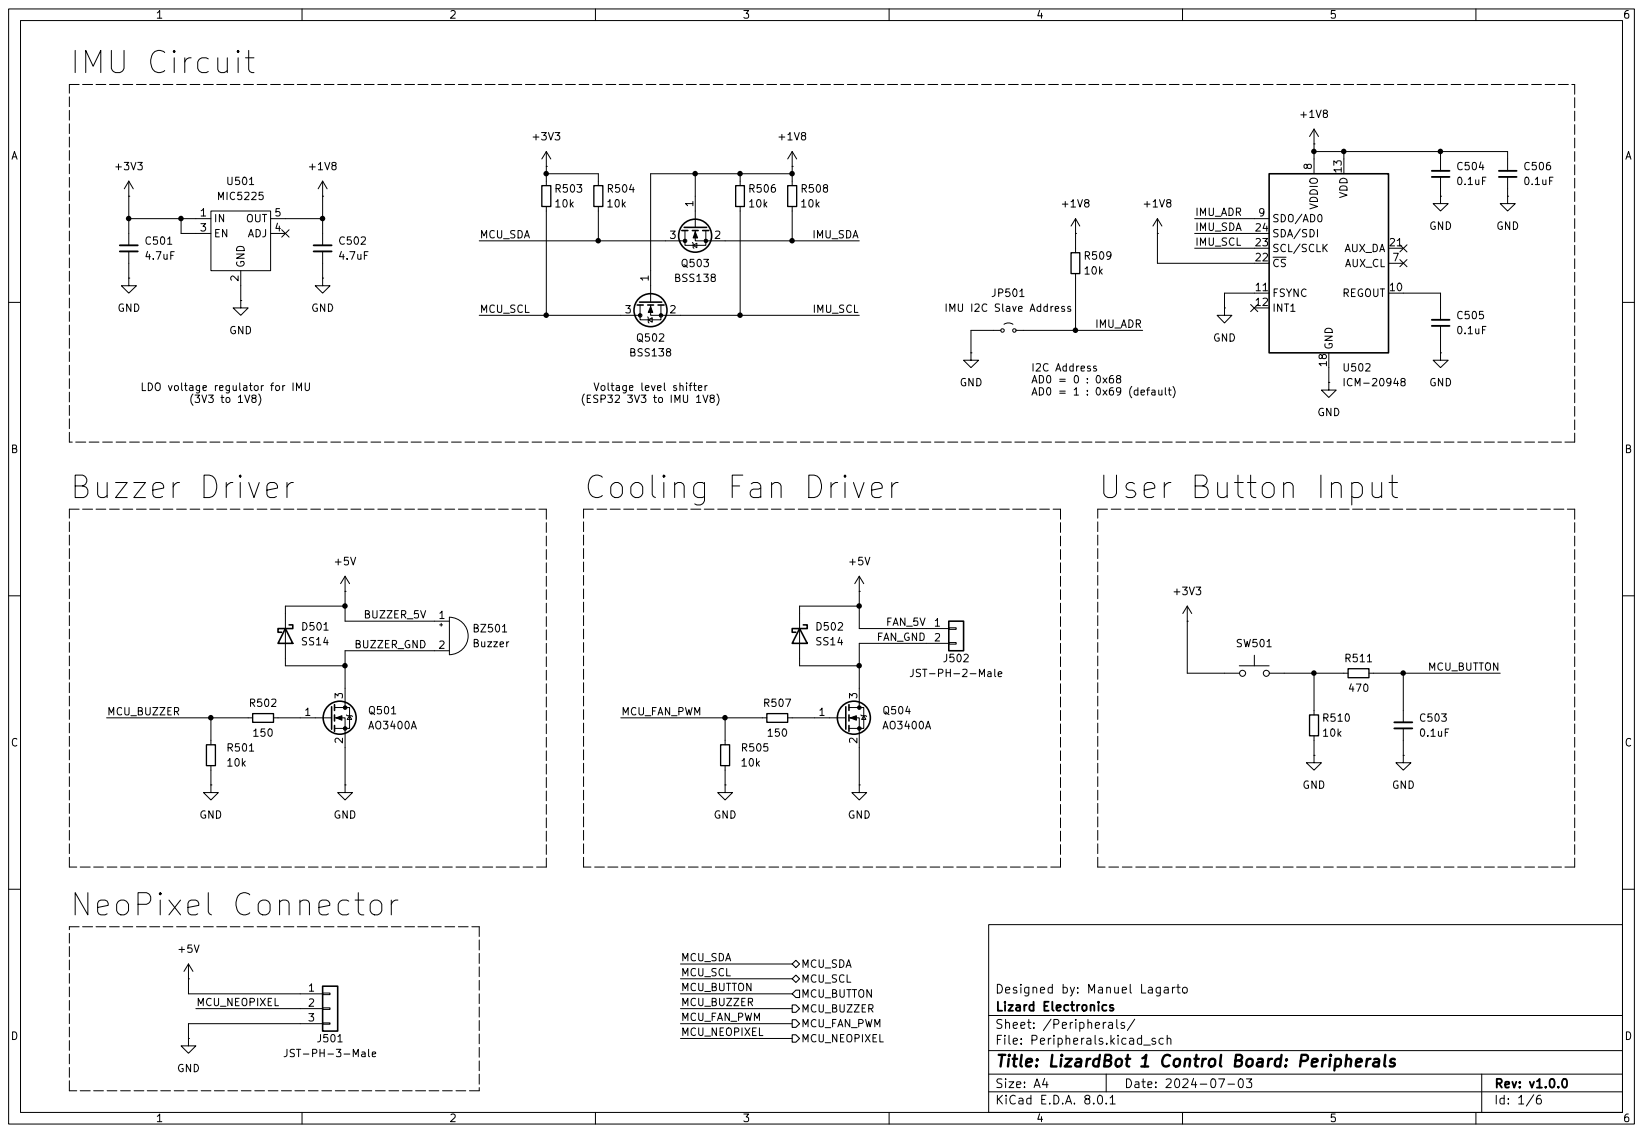
[picture p21: page 5]

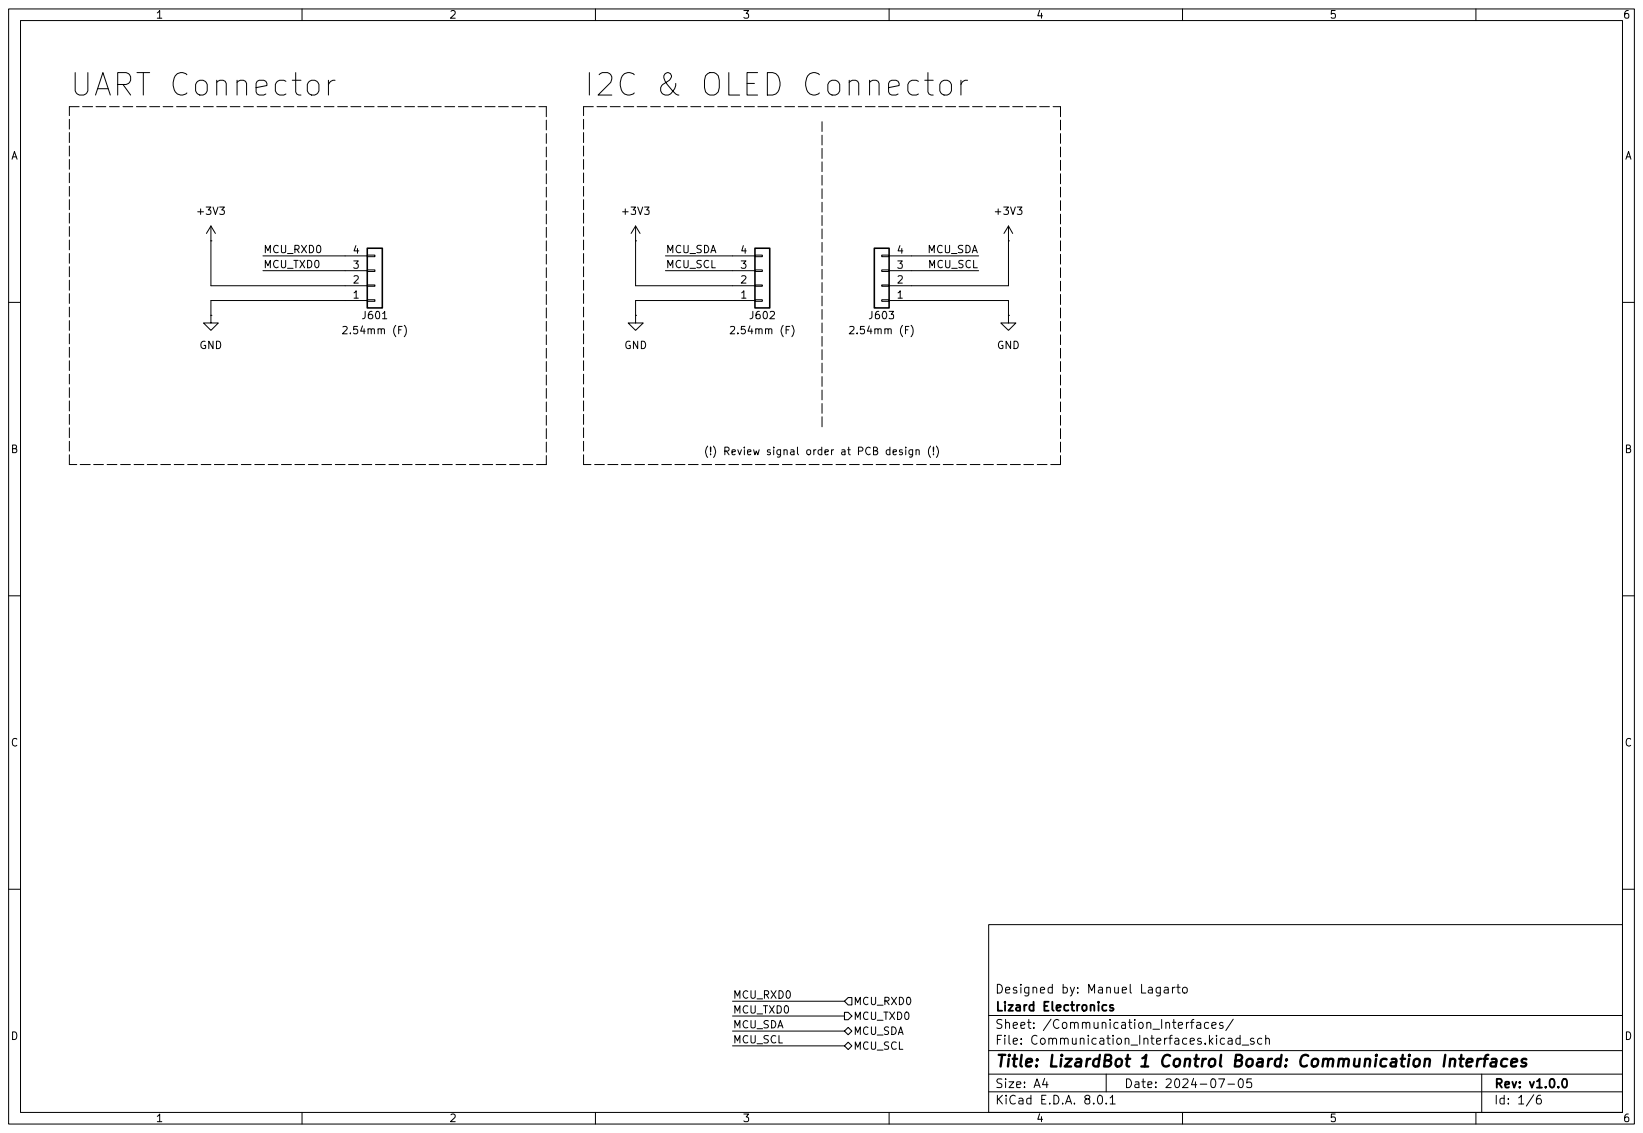
[picture p22: page 6]
