lizard-electronics/LizardBot1_ProjectFiles/1_Hardware/SPICE/LizardBot1_ControlBoard_SPICE_CircuitProtection.asc

C1: cap; 22µ; V=35 Irms=1.63 Rser=0.07 Lser=0 mfg="Vishay" pn="T55V226M035" type="Tantalum Polymer"
D1: zener; BZX84C12L
M1: pmos; AO4630_P
R1: res; 1k
R2: res; 4
V1: voltage; 12
Named nets: 0
.tran 0 1 0 0.1
.dc V1 -12 12 0.5
