lizard-electronics/LizardBot1_ProjectFiles/1_Hardware/PCB/LizardBot1_ControlBoard_v1/LizardBot1_ControlBoard_v1.kicad_pcb

## KiCad design 1_Hardware/PCB/LizardBot1_ControlBoard_v1/LizardBot1_ControlBoard_v1.kicad_pcb (2024-07-31)

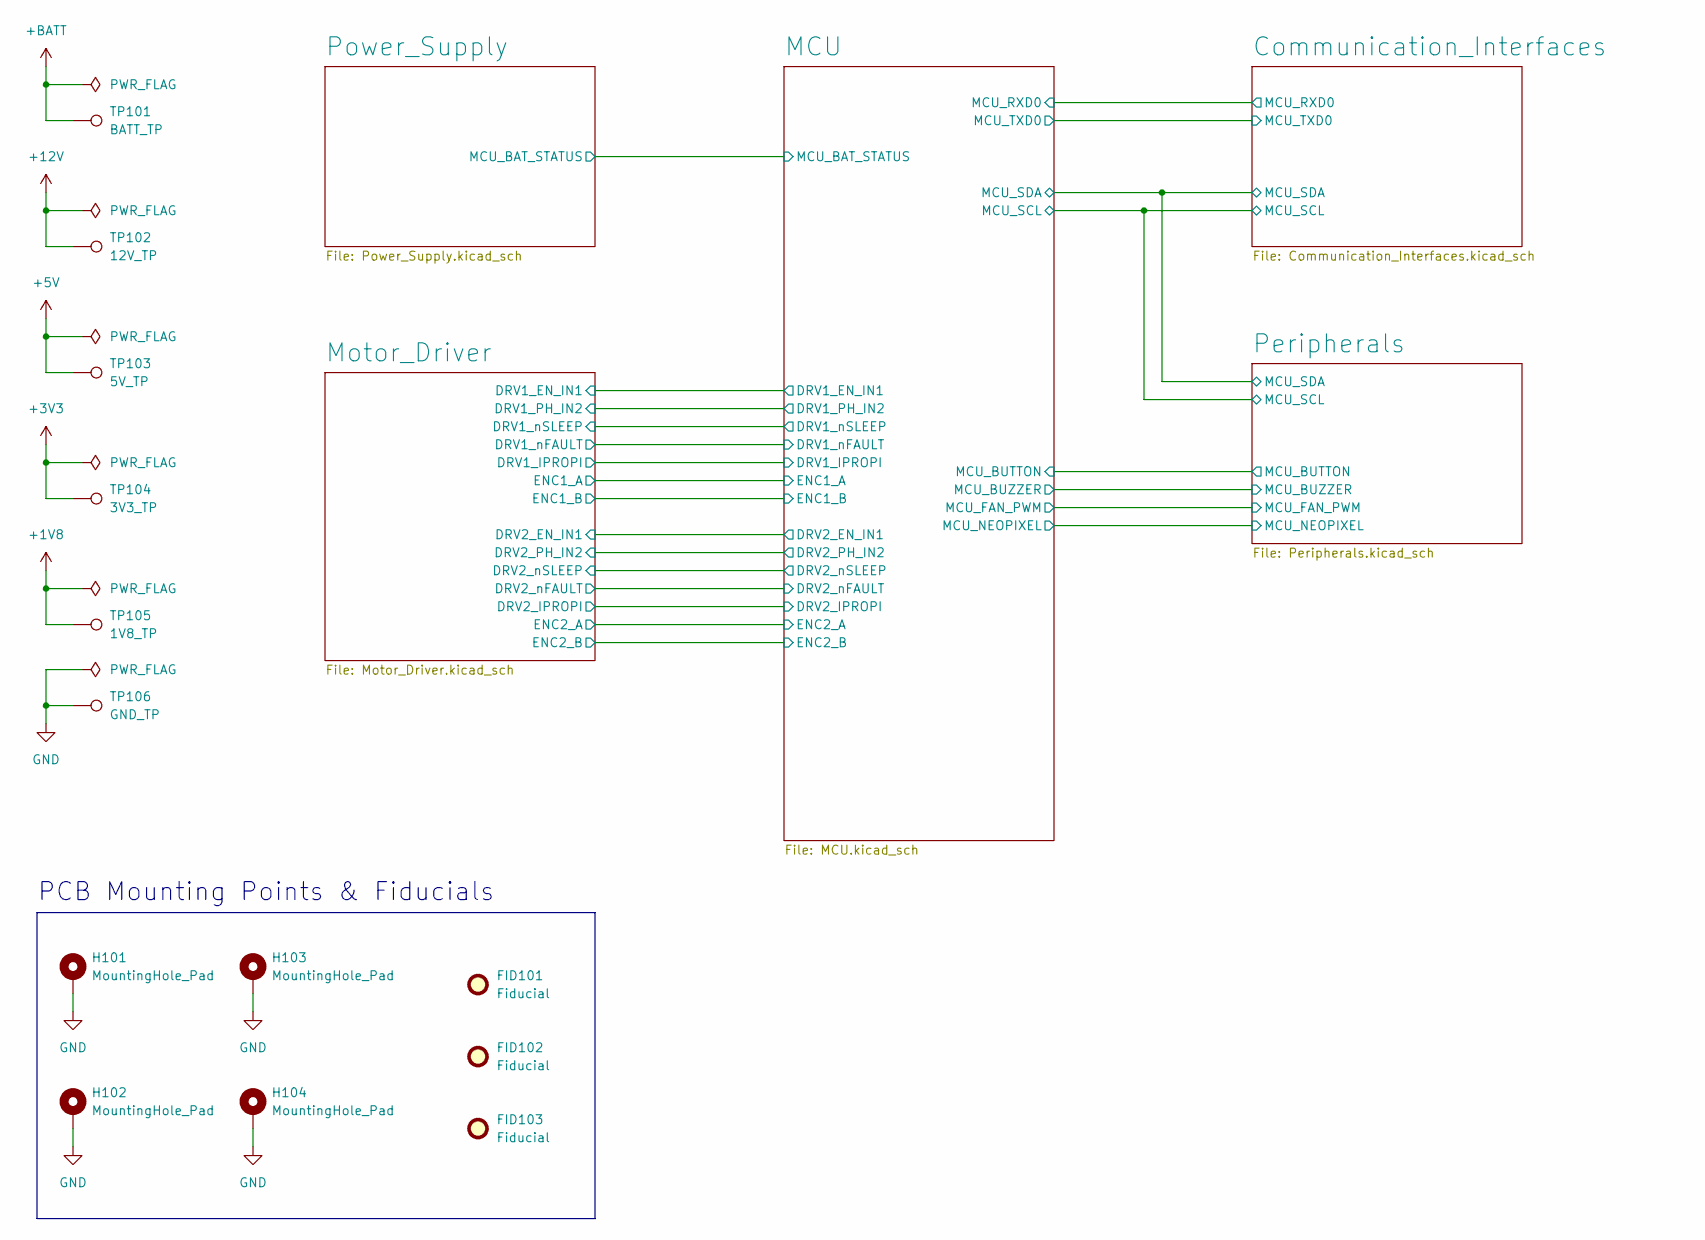
[picture p23: schematic LizardBot1_ControlBoard_v1.kicad_sch, LizardBot 1 Control Board: Hierarchical Sheet]

Parts:
FID101, FID102, FID103: Fiducial; Fiducial_1mm_Mask2mm
H101, H102, H103, H104: MountingHole_Pad; MountingHole_3.2mm_M3_Pad_Via
TP101: BATT_TP; TestPoint_Pad_D1.5mm
TP102: 12V_TP; TestPoint_Pad_D1.5mm
TP103: 5V_TP; TestPoint_Pad_D1.5mm
TP104: 3V3_TP; TestPoint_Pad_D1.5mm
TP105: 1V8_TP; TestPoint_Pad_D1.5mm
TP106: GND_TP; TestPoint_Pad_D1.5mm

Connections:
+1V8: TP105.1; also elsewhere on the board
+3V3: TP104.1; also elsewhere on the board
+5V: TP103.1; also elsewhere on the board
+12V: TP102.1; also elsewhere on the board
+BATT: TP101.1; also elsewhere on the board
GND: H101.1, H102.1, H103.1, H104.1, TP106.1; also elsewhere on the board

Notes on the sheet:
PCB Mounting Points & Fiducials

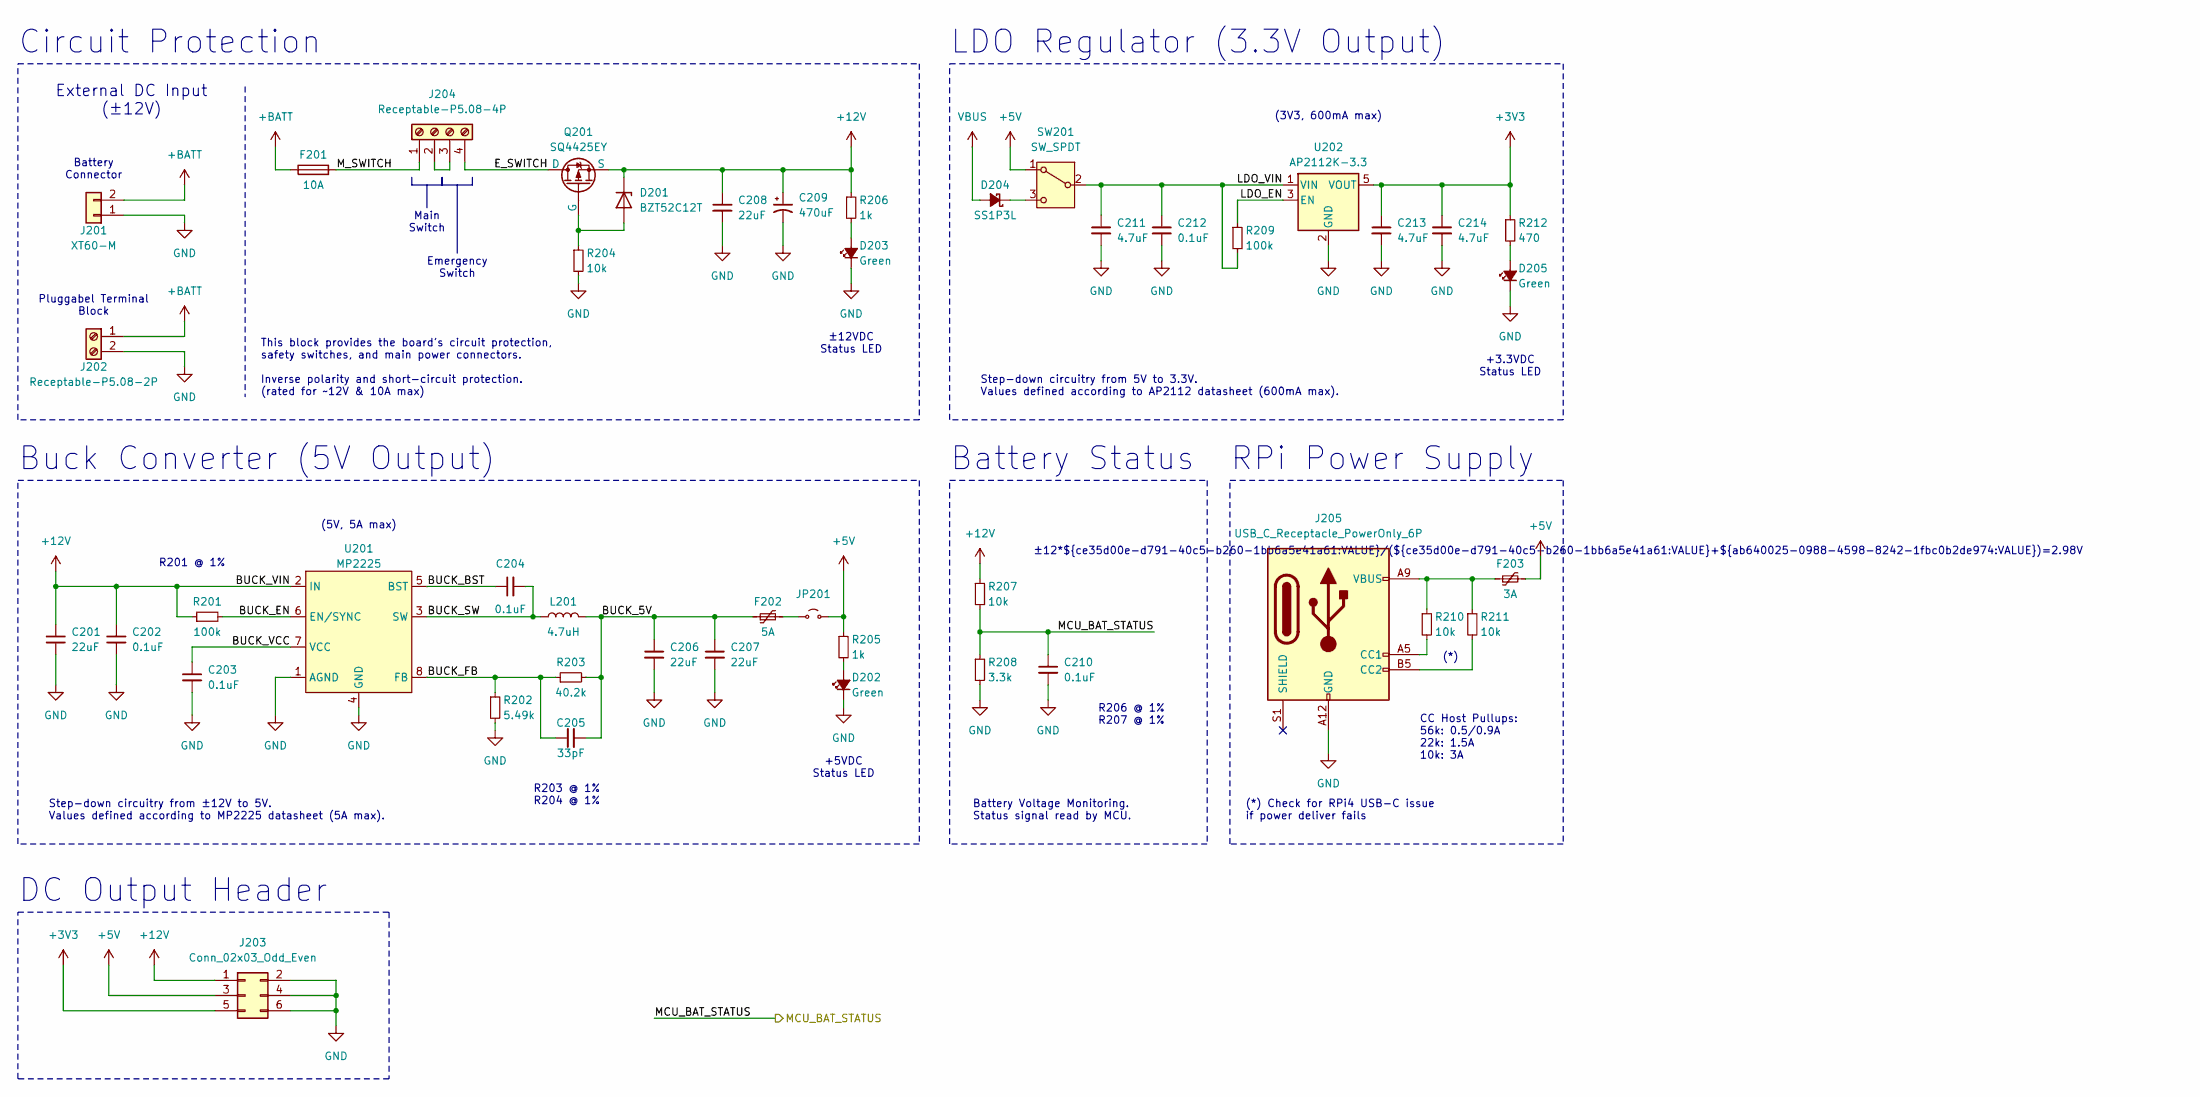
[picture p24: schematic Power_Supply.kicad_sch, LizardBot 1 Control Board: Power Supply]

Parts:
C201, C206, C207, C208: 22uF; C_0805_2012Metric_Pad1.18x1.45mm_HandSolder
C202, C212: 0.1uF; C_0805_2012Metric_Pad1.18x1.45mm_HandSolder
C203, C204, C210: 0.1uF; C_0603_1608Metric_Pad1.08x0.95mm_HandSolder
C205: 33pF; C_0603_1608Metric_Pad1.08x0.95mm_HandSolder
C209: 470uF; CP_Elec_8x10
C211, C213, C214: 4.7uF; C_0805_2012Metric_Pad1.18x1.45mm_HandSolder
D201: BZT52C12T; D_SOD-523
D202, D203, D205: Green; LED_0805_2012Metric_Pad1.15x1.40mm_HandSolder
D204: SS1P3L; D_SMP_DO-220AA
F201: 10A; Fuseholder_LittelFuse_5x20mm_0PTF0078P
F202: 5A; Fuse_1812_4532Metric_Pad1.30x3.40mm_HandSolder
F203: 3A; Fuse_1206_3216Metric_Pad1.42x1.75mm_HandSolder
J201: XT60-M; AMASS_XT60PW-M_1x02_P7.20mm_Horizontal
J202: Receptable-P5.08-2P; PhoenixContact_MSTBA_2,5_2-G-5,08_1x02_P5.08mm_Horizontal
J203: Conn_02x03_Odd_Even; PinHeader_2x03_P2.54mm_Vertical
J204: Receptable-P5.08-4P; PhoenixContact_MSTBA_2,5_4-G-5,08_1x04_P5.08mm_Horizontal
J205: USB_C_Receptacle_PowerOnly_6P; USB_C_Receptacle_GCT_USB4085
JP201: Jumper_2_Small_Open; SolderJumper-2_P1.3mm_Open_TrianglePad1.0x1.5mm
L201: 4.7uH; L_Bourns_SRP7028A_7.3x6.6mm
Q201: SQ4425EY; SO-8_3.9x4.9mm_P1.27mm
R201, R209: 100k; R_0805_2012Metric_Pad1.20x1.40mm_HandSolder
R202: 5.49k; R_0805_2012Metric_Pad1.20x1.40mm_HandSolder
R203: 40.2k; R_0805_2012Metric_Pad1.20x1.40mm_HandSolder
R204, R207: 10k; R_0805_2012Metric_Pad1.20x1.40mm_HandSolder
R205, R206: 1k; R_0603_1608Metric_Pad0.98x0.95mm_HandSolder
R208: 3.3k; R_0805_2012Metric_Pad1.20x1.40mm_HandSolder
R210, R211: 10k; R_0603_1608Metric_Pad0.98x0.95mm_HandSolder
R212: 470; R_0603_1608Metric_Pad0.98x0.95mm_HandSolder
SW201: SW_SPDT; SW_Slide_SPDT_Straight_CK_OS102011MS2Q
U201: MP2225; SOT-23-8
U202: AP2112K-3.3; SOT-23-5

Connections:
+3V3: C213.1, C214.1, J203.5, R212.1, U202.5 (VOUT); also elsewhere on the board
+5V: F203.2, J203.3, JP201.2 (B), R205.1, SW201.1 (A); also elsewhere on the board
+12V: C201.1, C202.1, C208.1, C209.1, D201.1 (K), J203.1, Q201.1 (S), Q201.2 (S), Q201.3 (S), R201.1, R206.1, R207.1, U201.2 (IN); also elsewhere on the board
+BATT: F201.1, J201.2, J202.1; also elsewhere on the board
/MCU/MCU_BAT_STATUS: C210.1, R207.2, R208.1; also elsewhere on the board
/Power_Supply/BUCK_5V: C205.2, C206.1, C207.1, F202.1, L201.2, R203.2
/Power_Supply/BUCK_BST: C204.1, U201.5 (BST)
/Power_Supply/BUCK_EN: R201.2, U201.6 (EN/SYNC)
/Power_Supply/BUCK_FB: C205.1, R202.1, R203.1, U201.8 (FB)
/Power_Supply/BUCK_SW: C204.2, L201.1, U201.3 (SW)
/Power_Supply/BUCK_VCC: C203.1, U201.7 (VCC)
/Power_Supply/E_SWITCH: J204.4, Q201.5 (D), Q201.6 (D), Q201.7 (D), Q201.8 (D)
/Power_Supply/LDO_EN: R209.1, U202.3 (EN)
/Power_Supply/LDO_VIN: C211.1, C212.1, R209.2, SW201.2 (B), U202.1 (VIN)
/Power_Supply/M_SWITCH: F201.2, J204.1
GND: C201.2, C202.2, C203.2, C206.2, C207.2, C208.2, C209.2, C210.2, C211.2, C212.2, C213.2, C214.2, D202.1 (K), D203.1 (K), D205.1 (K), J201.1, J202.2, J203.2, J203.4, J203.6, J205.A12 (GND), J205.B12 (GND), R202.2, R204.2, R208.2, U201.1 (AGND), U201.4 (GND), U202.2 (GND); also elsewhere on the board
unnamed: D201.2 (A), Q201.4 (G), R204.1
unnamed: D202.2 (A), R205.2
unnamed: D203.2 (A), R206.2
unnamed: D204.1 (K), SW201.3 (C)
unnamed: D205.2 (A), R212.2
unnamed: F203.1, J205.A9 (VBUS), J205.B9 (VBUS), R210.1, R211.1
unnamed: J204.2, J204.3
unnamed: J205.A5 (CC1), R210.2
unnamed: J205.B5 (CC2), R211.2
unnamed: F202.2, JP201.1 (A)
VBUS: D204.2 (A); also elsewhere on the board

Notes on the sheet:
Circuit Protection
Battery Connector
CC Host Pullups: 56k: 0.5/0.9A 22k: 1.5A 10k: 3A
(3V3, 600mA max)
(*) Check for RPi4 USB-C issue if power deliver fails
±12*${ce35d00e-d791-40c5-b260-1bb6a5e41a61:VALUE}/(${ce35d00e-d791-40c5-b260-1bb6a5e41a61:VALUE}+${ab640025-0988-4598-8242-1fbc0b2de974:VALUE})=2.98V
LDO Regulator (3.3V Output)
Pluggabel Terminal Block
Battery Voltage Monitoring. Status signal read by MCU.
+3.3VDC Status LED
R201 @ 1%
±12VDC Status LED
Battery Status
(5V, 5A max)
External DC Input (±12V)
DC Output Header
(*)
Step-down circuitry from 5V to 3.3V. Values defined according to AP2112 datasheet (600mA max).
This block provides the board's circuit protection, safety switches, and main power connectors. Inverse polarity and short-circuit protection. (rated for ~12V & 10A max)
R203 @ 1% R204 @ 1%
Main Switch
Buck Converter (5V Output)
R206 @ 1% R207 @ 1%
RPi Power Supply
Step-down circuitry from ±12V to 5V. Values defined according to MP2225 datasheet (5A max).
Emergency Switch
+5VDC Status LED

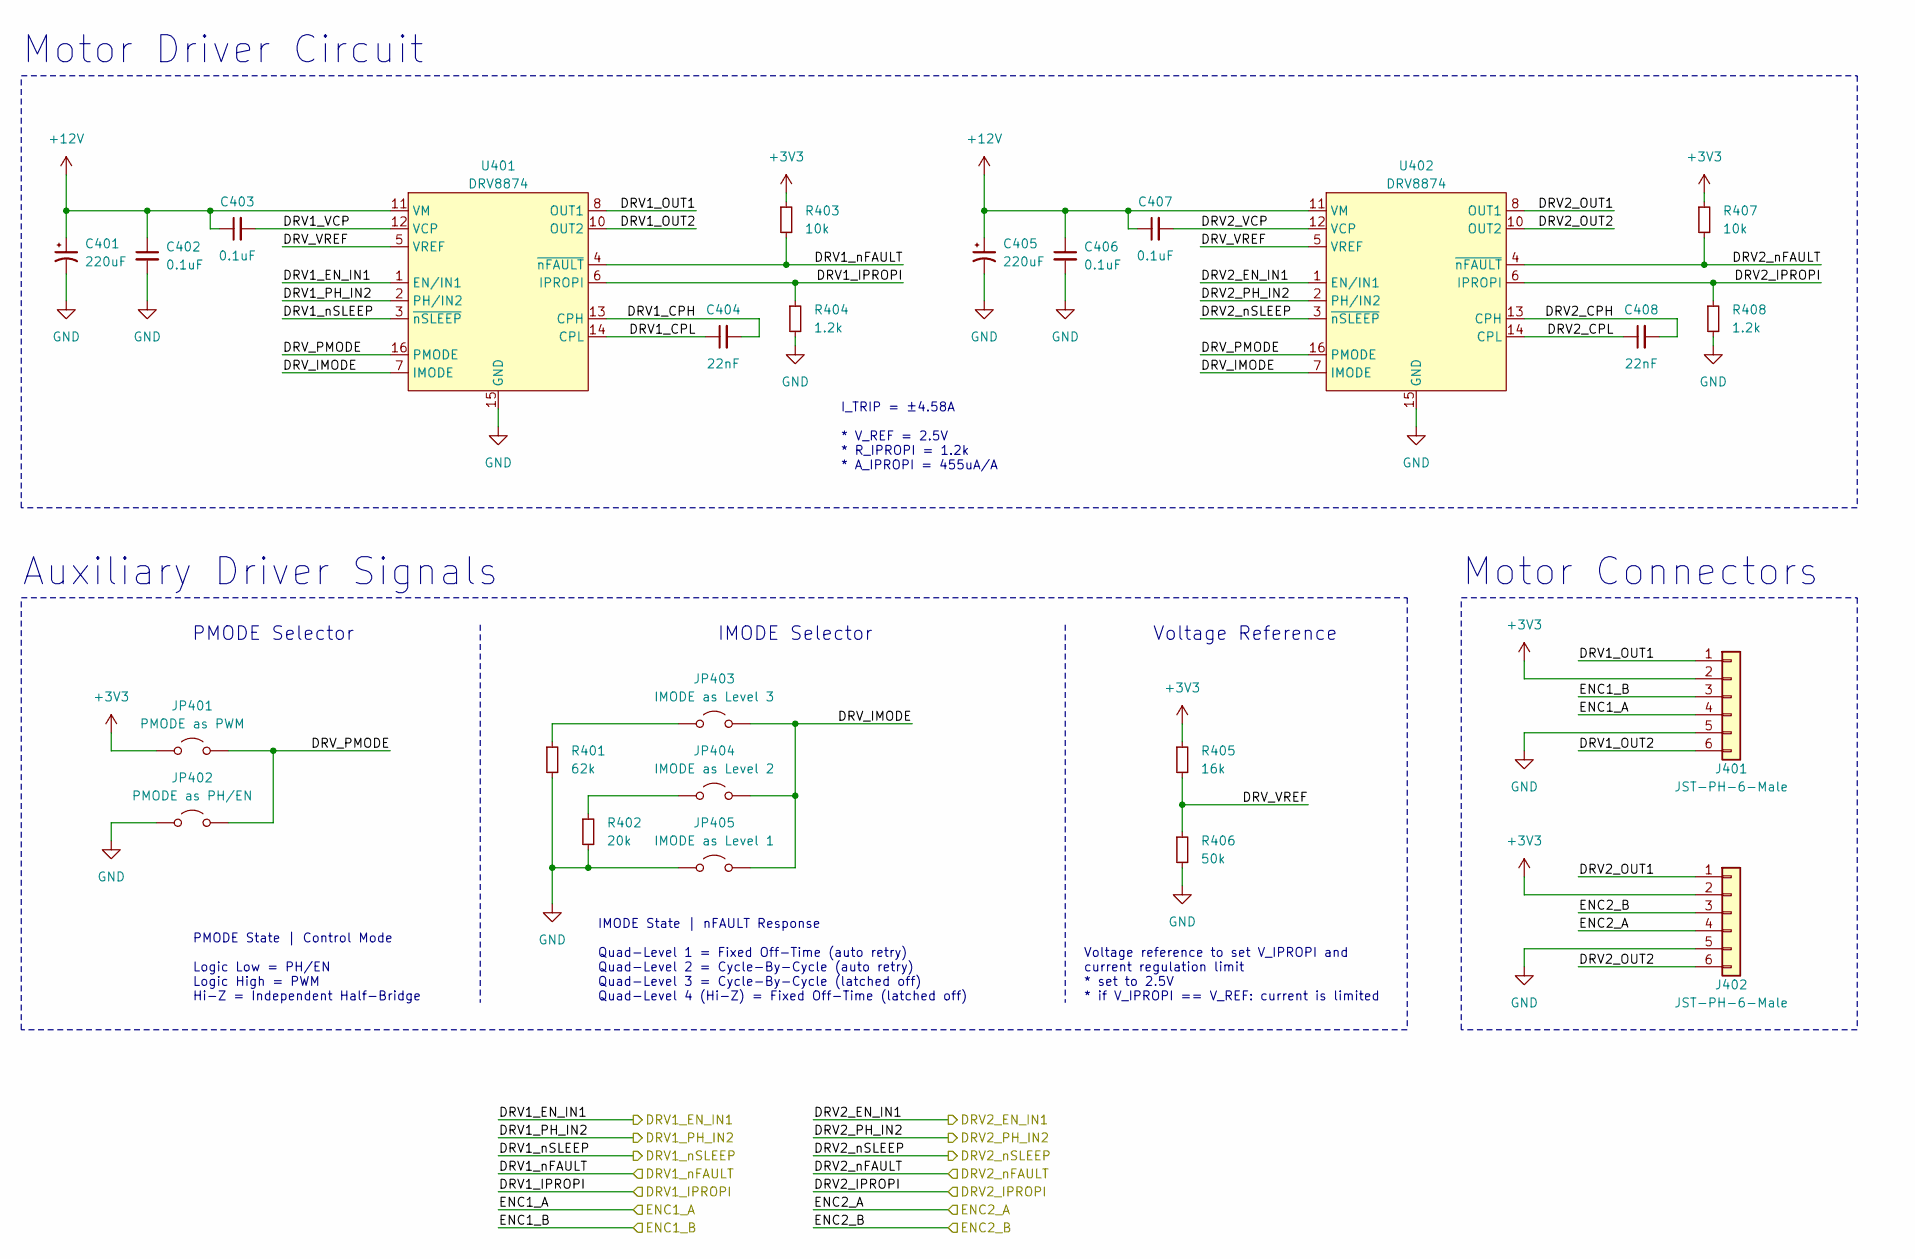
[picture p25: schematic Motor_Driver.kicad_sch, LizardBot 1 Control Board: Motor Driver]

Parts:
C401, C405: 220uF; CP_Elec_8x10
C402, C403, C406, C407: 0.1uF; C_0603_1608Metric_Pad1.08x0.95mm_HandSolder
C404, C408: 22nF; C_0805_2012Metric_Pad1.18x1.45mm_HandSolder
J401, J402: JST-PH-6-Male; JST_PH_S6B-PH-K_1x06_P2.00mm_Horizontal
JP401: PMODE as PWM; SolderJumper-2_P1.3mm_Open_TrianglePad1.0x1.5mm
JP402: PMODE as PH/EN; SolderJumper-2_P1.3mm_Open_TrianglePad1.0x1.5mm
JP403: IMODE as Level 3; SolderJumper-2_P1.3mm_Open_TrianglePad1.0x1.5mm
JP404: IMODE as Level 2; SolderJumper-2_P1.3mm_Open_TrianglePad1.0x1.5mm
JP405: IMODE as Level 1; SolderJumper-2_P1.3mm_Open_TrianglePad1.0x1.5mm
R401: 62k; R_0805_2012Metric_Pad1.20x1.40mm_HandSolder
R402: 20k; R_0805_2012Metric_Pad1.20x1.40mm_HandSolder
R403, R407: 10k; R_0805_2012Metric_Pad1.20x1.40mm_HandSolder
R404, R408: 1.2k; R_0805_2012Metric_Pad1.20x1.40mm_HandSolder
R405: 16k; R_0805_2012Metric_Pad1.20x1.40mm_HandSolder
R406: 50k; R_0805_2012Metric_Pad1.20x1.40mm_HandSolder
U401, U402: DRV8874; HTSSOP-16-1EP_4.4x5mm_P0.65mm_EP3.4x5mm_Mask3x3mm_ThermalVi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

Connections:
+3V3: J401.2, J402.2, JP401.1 (A), R403.1, R405.1, R407.1; also elsewhere on the board
+12V: C401.1, C402.1, C403.1, C405.1, C406.1, C407.1, U401.11 (VM), U402.11 (VM); also elsewhere on the board
/MCU/DRV1_EN_IN1: U401.1 (EN/IN1); also elsewhere on the board
/MCU/DRV1_IPROPI: R404.1, U401.6 (IPROPI); also elsewhere on the board
/MCU/DRV1_PH_IN2: U401.2 (PH/IN2); also elsewhere on the board
/MCU/DRV1_nFAULT: R403.2, U401.4 (~nFAULT); also elsewhere on the board
/MCU/DRV1_nSLEEP: U401.3 (~nSLEEP); also elsewhere on the board
/MCU/DRV2_EN_IN1: U402.1 (EN/IN1); also elsewhere on the board
/MCU/DRV2_IPROPI: R408.1, U402.6 (IPROPI); also elsewhere on the board
/MCU/DRV2_PH_IN2: U402.2 (PH/IN2); also elsewhere on the board
/MCU/DRV2_nFAULT: R407.2, U402.4 (~nFAULT); also elsewhere on the board
/MCU/DRV2_nSLEEP: U402.3 (~nSLEEP); also elsewhere on the board
/MCU/ENC1_A: J401.4; also elsewhere on the board
/MCU/ENC1_B: J401.3; also elsewhere on the board
/MCU/ENC2_A: J402.4; also elsewhere on the board
/MCU/ENC2_B: J402.3; also elsewhere on the board
/Motor_Driver/DRV1_CPH: C404.2, U401.13 (CPH)
/Motor_Driver/DRV1_CPL: C404.1, U401.14 (CPL)
/Motor_Driver/DRV1_OUT1: J401.1, U401.8 (OUT1)
/Motor_Driver/DRV1_OUT2: J401.6, U401.10 (OUT2)
/Motor_Driver/DRV1_VCP: C403.2, U401.12 (VCP)
/Motor_Driver/DRV2_CPH: C408.2, U402.13 (CPH)
/Motor_Driver/DRV2_CPL: C408.1, U402.14 (CPL)
/Motor_Driver/DRV2_OUT1: J402.1, U402.8 (OUT1)
/Motor_Driver/DRV2_OUT2: J402.6, U402.10 (OUT2)
/Motor_Driver/DRV2_VCP: C407.2, U402.12 (VCP)
/Motor_Driver/DRV_IMODE: JP403.2 (B), JP404.2 (B), JP405.2 (B), U401.7 (IMODE), U402.7 (IMODE)
/Motor_Driver/DRV_PMODE: JP401.2 (B), JP402.2 (B), U401.16 (PMODE), U402.16 (PMODE)
/Motor_Driver/DRV_VREF: R405.2, R406.1, U401.5 (VREF), U402.5 (VREF)
GND: C401.2, C402.2, C405.2, C406.2, J401.5, J402.5, JP402.1 (A), JP405.1 (A), R401.2, R402.2, R404.2, R406.2, R408.2, U401.9 (PGND), U401.15 (GND), U401.17 (PAD), U402.9 (PGND), U402.15 (GND), U402.17 (PAD); also elsewhere on the board
unnamed: JP403.1 (A), R401.1
unnamed: JP404.1 (A), R402.1

Notes on the sheet:
I_TRIP = ±4.58A * V_REF = 2.5V * R_IPROPI = 1.2k * A_IPROPI = 455uA/A
IMODE State | nFAULT Response Quad-Level 1 = Fixed Off-Time (auto retry) Quad-Level 2 = Cycle-By-Cycle (auto retry) Quad-Level 3 = Cycle-By-Cycle (latched off) Quad-Level 4 (Hi-Z) = Fixed Off-Time (latched off)
Voltage Reference
IMODE Selector
Motor Driver Circuit
PMODE Selector
PMODE State | Control Mode Logic Low = PH/EN Logic High = PWM Hi-Z = Independent Half-Bridge
Auxiliary Driver Signals
Motor Connectors
Voltage reference to set V_IPROPI and current regulation limit * set to 2.5V * if V_IPROPI == V_REF: current is limited

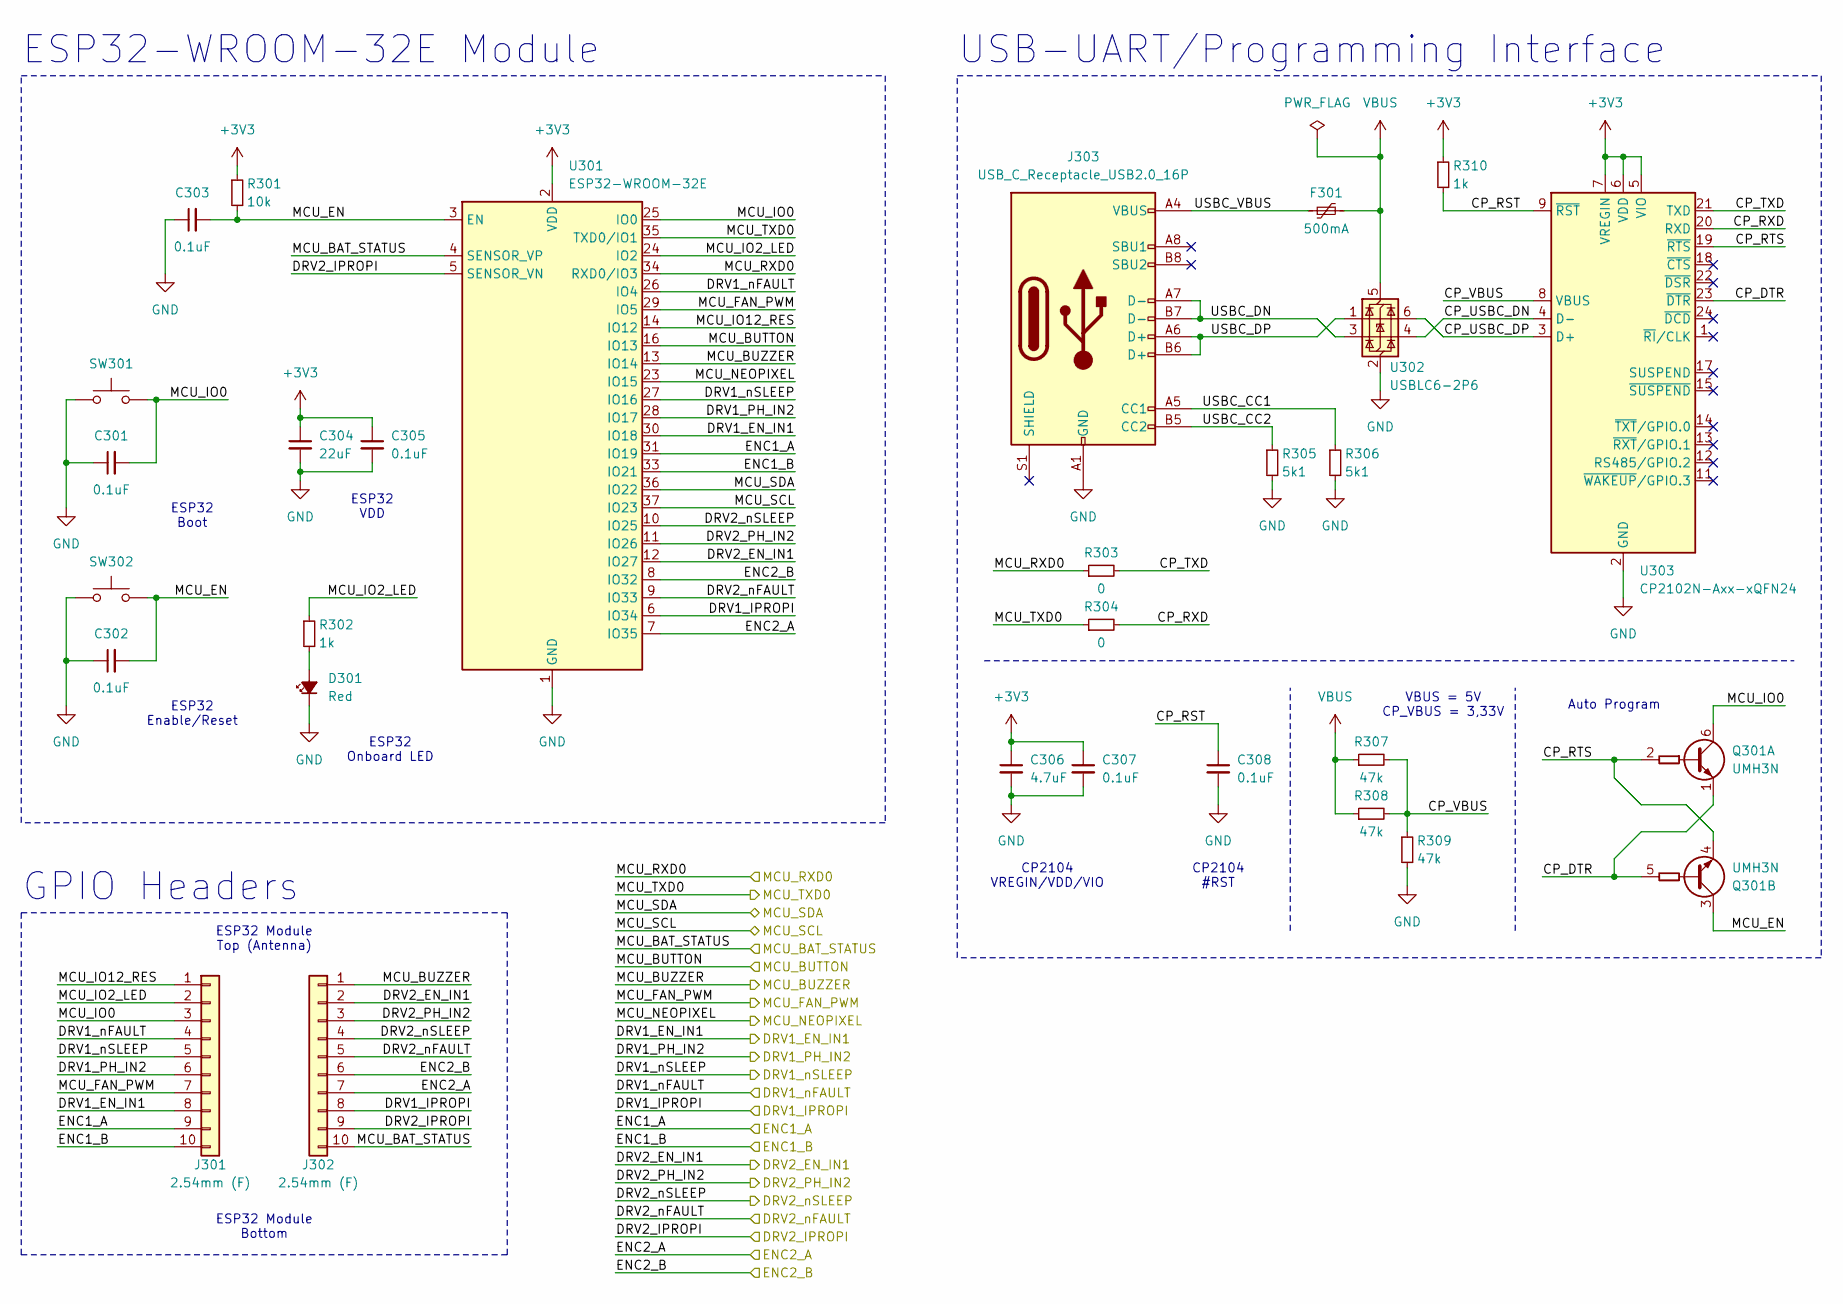
[picture p26: schematic MCU.kicad_sch, LizardBot 1 Control Board: MCU]

Parts:
C301, C302, C303: 0.1uF; C_0603_1608Metric_Pad1.08x0.95mm_HandSolder
C304: 22uF; C_0805_2012Metric_Pad1.18x1.45mm_HandSolder
C305, C307, C308: 0.1uF; C_0805_2012Metric_Pad1.18x1.45mm_HandSolder
C306: 4.7uF; C_0805_2012Metric_Pad1.18x1.45mm_HandSolder
D301: Red; LED_1206_3216Metric_Pad1.42x1.75mm_HandSolder
F301: 500mA; Fuse_1206_3216Metric_Pad1.42x1.75mm_HandSolder
J301, J302: 2.54mm (F); PinHeader_1x10_P2.54mm_Vertical
J303: USB_C_Receptacle_USB2.0_16P; USB_C_Receptacle_GCT_USB4085
Q301: UMH3N; SOT-363_SC-70-6
R301: 10k; R_0603_1608Metric_Pad0.98x0.95mm_HandSolder
R302, R310: 1k; R_0603_1608Metric_Pad0.98x0.95mm_HandSolder
R303, R304: 0; R_0603_1608Metric_Pad0.98x0.95mm_HandSolder
R305, R306: 5k1; R_0603_1608Metric_Pad0.98x0.95mm_HandSolder
R307, R308, R309: 47k; R_0603_1608Metric_Pad0.98x0.95mm_HandSolder
SW301, SW302: SW_Push; SW_SPST_TL3342
U301: ESP32-WROOM-32E; ESP32-WROOM-32D
U302: USBLC6-2P6; SOT-666
U303: CP2102N-Axx-xQFN24; QFN-24-1EP_4x4mm_P0.5mm_EP2.6x2.6mm

Connections:
+3V3: C304.1, C305.1, C306.1, C307.1, R301.1, R310.1, U301.2 (VDD), U303.5 (VIO), U303.6 (VDD), U303.7 (VREGIN); also elsewhere on the board
/Communication_Interfaces/MCU_RXD0: R303.1, U301.34 (RXD0/IO3); also elsewhere on the board
/Communication_Interfaces/MCU_SCL: U301.37 (IO23); also elsewhere on the board
/Communication_Interfaces/MCU_SDA: U301.36 (IO22); also elsewhere on the board
/Communication_Interfaces/MCU_TXD0: R304.1, U301.35 (TXD0/IO1); also elsewhere on the board
/MCU/CP_DTR: Q301.1 (E1), Q301.5 (B2), U303.23 (~DTR)
/MCU/CP_RST: C308.1, R310.2, U303.9 (~RST)
/MCU/CP_RTS: Q301.2 (B1), Q301.4 (E2), U303.19 (~RTS)
/MCU/CP_RXD: R304.2, U303.20 (RXD)
/MCU/CP_TXD: R303.2, U303.21 (TXD)
/MCU/CP_USBC_DN: U302.4 (I/O2), U303.4 (D-)
/MCU/CP_USBC_DP: U302.6 (I/O1), U303.3 (D+)
/MCU/CP_VBUS: R307.2, R308.2, R309.1, U303.8 (VBUS)
/MCU/DRV1_EN_IN1: J301.8, U301.30 (IO18); also elsewhere on the board
/MCU/DRV1_IPROPI: J302.8, U301.6 (IO34); also elsewhere on the board
/MCU/DRV1_PH_IN2: J301.6, U301.28 (IO17); also elsewhere on the board
/MCU/DRV1_nFAULT: J301.4, U301.26 (IO4); also elsewhere on the board
/MCU/DRV1_nSLEEP: J301.5, U301.27 (IO16); also elsewhere on the board
/MCU/DRV2_EN_IN1: J302.2, U301.12 (IO27); also elsewhere on the board
/MCU/DRV2_IPROPI: J302.9, U301.5 (SENSOR_VN); also elsewhere on the board
/MCU/DRV2_PH_IN2: J302.3, U301.11 (IO26); also elsewhere on the board
/MCU/DRV2_nFAULT: J302.5, U301.9 (IO33); also elsewhere on the board
/MCU/DRV2_nSLEEP: J302.4, U301.10 (IO25); also elsewhere on the board
/MCU/ENC1_A: J301.9, U301.31 (IO19); also elsewhere on the board
/MCU/ENC1_B: J301.10, U301.33 (IO21); also elsewhere on the board
/MCU/ENC2_A: J302.7, U301.7 (IO35); also elsewhere on the board
/MCU/ENC2_B: J302.6, U301.8 (IO32); also elsewhere on the board
/MCU/MCU_BAT_STATUS: J302.10, U301.4 (SENSOR_VP); also elsewhere on the board
/MCU/MCU_BUTTON: U301.16 (IO13); also elsewhere on the board
/MCU/MCU_BUZZER: J302.1, U301.13 (IO14); also elsewhere on the board
/MCU/MCU_EN: C302.2, C303.2, Q301.3 (C2), R301.2, SW302.2, U301.3 (EN)
/MCU/MCU_FAN_PWM: J301.7, U301.29 (IO5); also elsewhere on the board
/MCU/MCU_IO0: C301.2, J301.3, Q301.6 (C1), SW301.2, U301.25 (IO0)
/MCU/MCU_IO2_LED: J301.2, R302.1, U301.24 (IO2)
/MCU/MCU_IO12_RES: J301.1, U301.14 (IO12)
/MCU/MCU_NEOPIXEL: U301.23 (IO15); also elsewhere on the board
/MCU/USBC_CC1: J303.A5 (CC1), R306.1
/MCU/USBC_CC2: J303.B5 (CC2), R305.1
/MCU/USBC_DN: J303.A7 (D-), J303.B7 (D-), U302.3 (I/O2)
/MCU/USBC_DP: J303.A6 (D+), J303.B6 (D+), U302.1 (I/O1)
/MCU/USBC_VBUS: F301.1, J303.A4 (VBUS), J303.A9 (VBUS), J303.B4 (VBUS), J303.B9 (VBUS)
GND: C301.1, C302.1, C303.1, C304.2, C305.2, C306.2, C307.2, C308.2, D301.1 (K), J303.A1 (GND), J303.A12 (GND), J303.B1 (GND), J303.B12 (GND), R305.2, R306.2, R309.2, SW301.1, SW302.1, U301.1 (GND), U301.15 (GND), U301.38 (GND), U301.39 (GND), U302.2 (GND), U303.2 (GND), U303.25 (GND); also elsewhere on the board
unnamed: D301.2 (A), R302.2
VBUS: F301.2, R307.1, R308.1, U302.5 (VBUS); also elsewhere on the board

Notes on the sheet:
ESP32 Module Top (Antenna)
ESP32 VDD
Auto Program
CP2104 VREGIN/VDD/VIO
ESP32-WROOM-32E Module
CP2104 #RST
GPIO Headers
USB-UART/Programming Interface
ESP32 Onboard LED
ESP32 Enable/Reset
VBUS = 5V CP_VBUS = 3,33V
ESP32 Boot
ESP32 Module Bottom

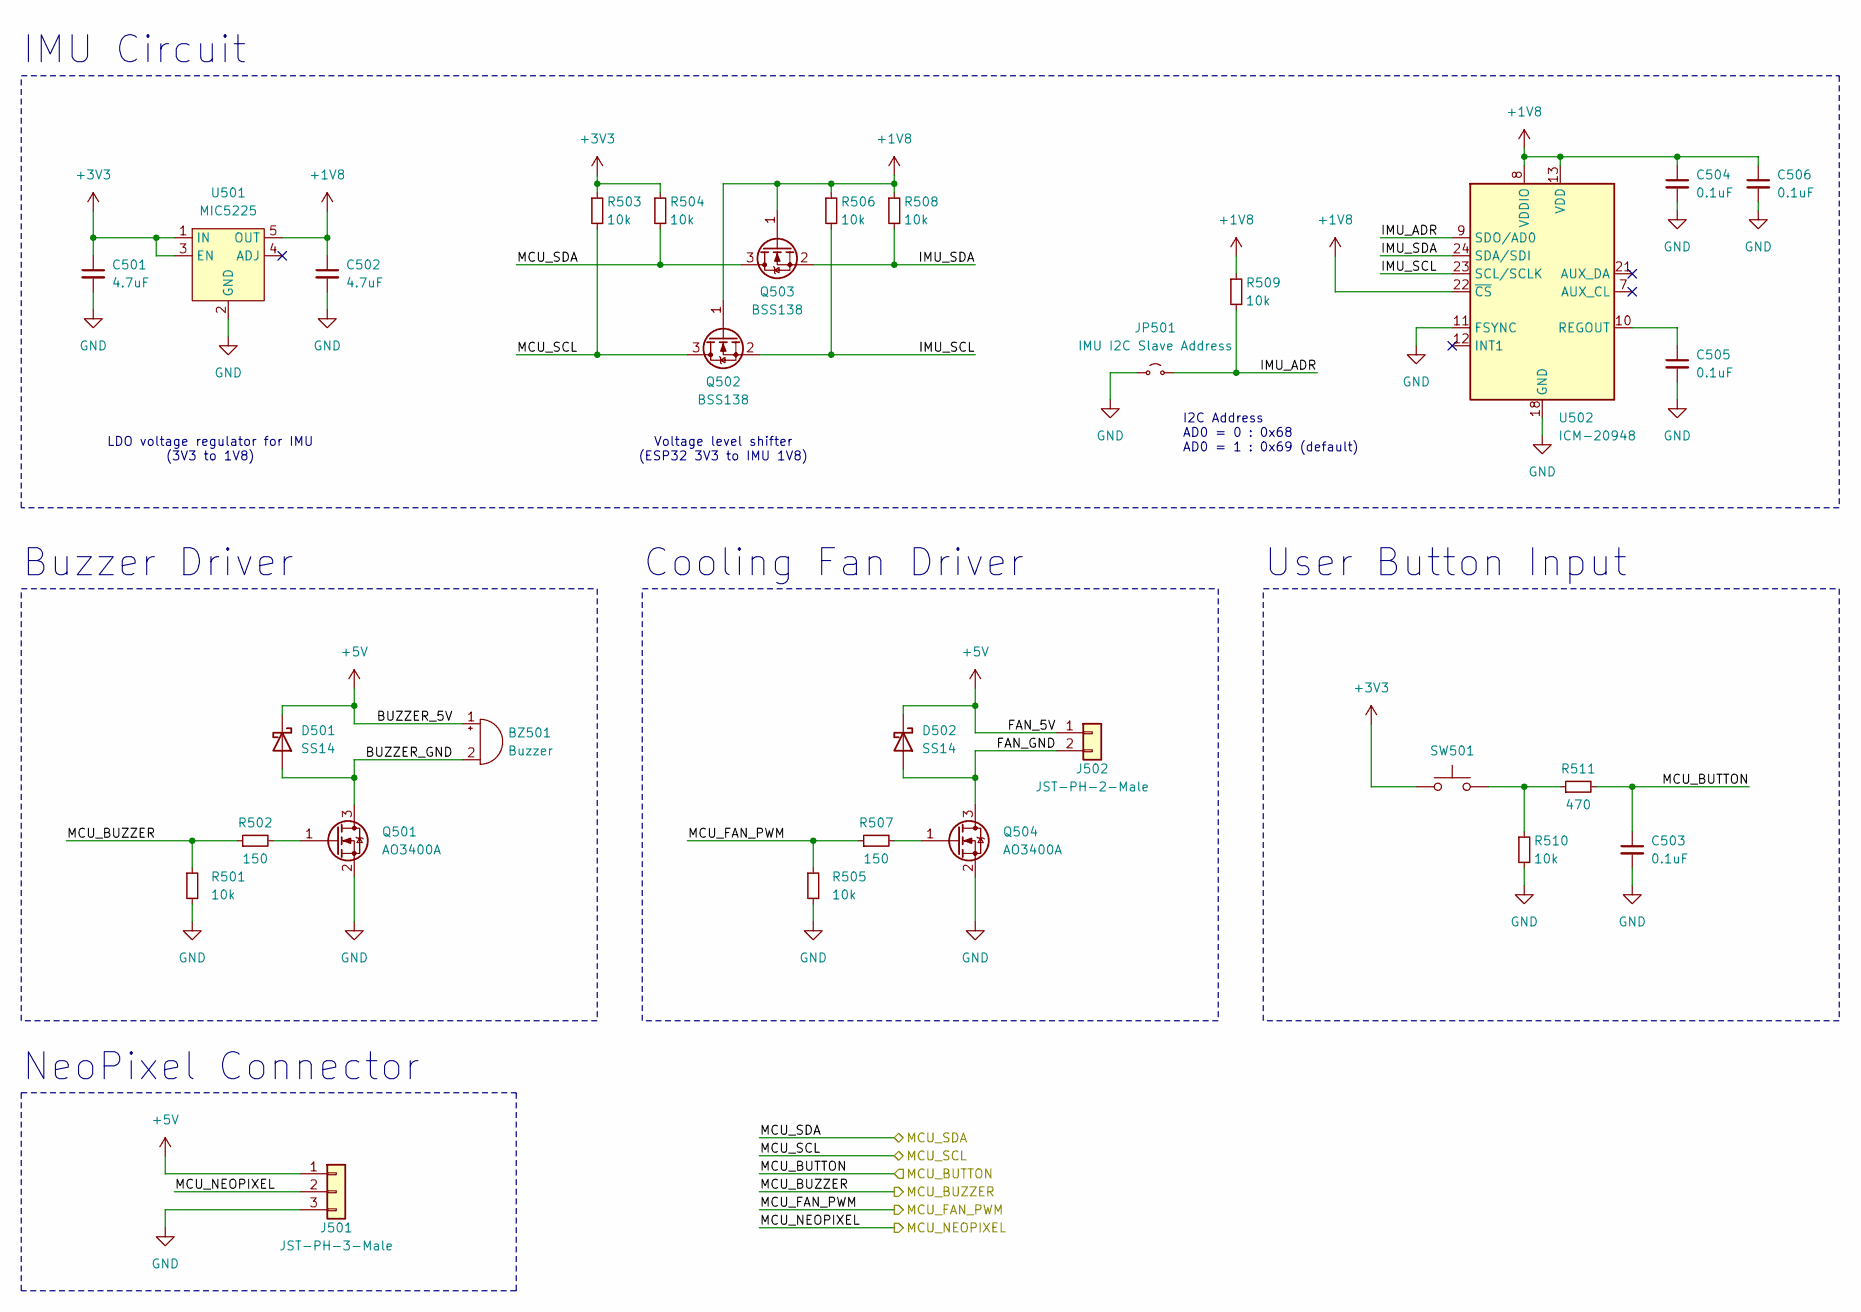
[picture p27: schematic Peripherals.kicad_sch, LizardBot 1 Control Board: Peripherals]

Parts:
BZ501: Buzzer; Buzzer_12x9.5RM7.6
C501, C502: 4.7uF; C_0805_2012Metric_Pad1.18x1.45mm_HandSolder
C503, C504, C505, C506: 0.1uF; C_0603_1608Metric_Pad1.08x0.95mm_HandSolder
D501, D502: SS14; D_SMA
J501: JST-PH-3-Male; JST_PH_S3B-PH-K_1x03_P2.00mm_Horizontal
J502: JST-PH-2-Male; JST_PH_S2B-PH-K_1x02_P2.00mm_Horizontal
JP501: IMU I2C Slave Address; SolderJumper-2_P1.3mm_Open_TrianglePad1.0x1.5mm
Q501, Q504: AO3400A; SOT-23
Q502, Q503: BSS138; SOT-23
R501, R505: 10k; R_0805_2012Metric_Pad1.20x1.40mm_HandSolder
R502, R507: 150; R_0805_2012Metric_Pad1.20x1.40mm_HandSolder
R503, R504, R506, R508, R509, R510: 10k; R_0603_1608Metric_Pad0.98x0.95mm_HandSolder
R511: 470; R_0603_1608Metric_Pad0.98x0.95mm_HandSolder
SW501: SW_Push; SW_PUSH-12mm
U501: MIC5225; SOT-23-5_HandSoldering
U502: ICM-20948; InvenSense_QFN-24_3x3mm_P0.4mm

Connections:
+1V8: C502.1, C504.1, C506.1, Q502.1 (G), Q503.1 (G), R506.1, R508.1, R509.1, U501.5 (OUT), U502.8 (VDDIO), U502.13 (VDD), U502.22 (~CS); also elsewhere on the board
+3V3: C501.1, R503.1, R504.1, SW501.1, U501.1 (IN), U501.3 (EN); also elsewhere on the board
+5V: BZ501.1 (+), D501.1 (K), D502.1 (K), J501.1, J502.1; also elsewhere on the board
/Communication_Interfaces/MCU_SCL: Q502.3 (D), R503.2; also elsewhere on the board
/Communication_Interfaces/MCU_SDA: Q503.3 (D), R504.2; also elsewhere on the board
/MCU/MCU_BUTTON: C503.1, R511.2; also elsewhere on the board
/MCU/MCU_BUZZER: R501.1, R502.1; also elsewhere on the board
/MCU/MCU_FAN_PWM: R505.1, R507.1; also elsewhere on the board
/MCU/MCU_NEOPIXEL: J501.2; also elsewhere on the board
/Peripherals/BUZZER_GND: BZ501.2 (-), D501.2 (A), Q501.3 (D)
/Peripherals/FAN_GND: D502.2 (A), J502.2, Q504.3 (D)
/Peripherals/IMU_ADR: JP501.2 (B), R509.2, U502.9 (SDO/AD0)
/Peripherals/IMU_SCL: Q502.2 (S), R506.2, U502.23 (SCL/SCLK)
/Peripherals/IMU_SDA: Q503.2 (S), R508.2, U502.24 (SDA/SDI)
GND: C501.2, C502.2, C503.2, C504.2, C505.2, C506.2, J501.3, JP501.1 (A), Q501.2 (S), Q504.2 (S), R501.2, R505.2, R510.2, U501.2 (GND), U502.11 (FSYNC), U502.18 (GND), U502.20 (GND); also elsewhere on the board
unnamed: Q501.1 (G), R502.2
unnamed: Q504.1 (G), R507.2
unnamed: R510.1, R511.1, SW501.2
unnamed: C505.1, U502.10 (REGOUT)

Notes on the sheet:
IMU Circuit
I2C Address AD0 = 0 : 0x68 AD0 = 1 : 0x69 (default)
NeoPixel Connector
Voltage level shifter (ESP32 3V3 to IMU 1V8)
LDO voltage regulator for IMU (3V3 to 1V8)
User Button Input
Cooling Fan Driver
Buzzer Driver

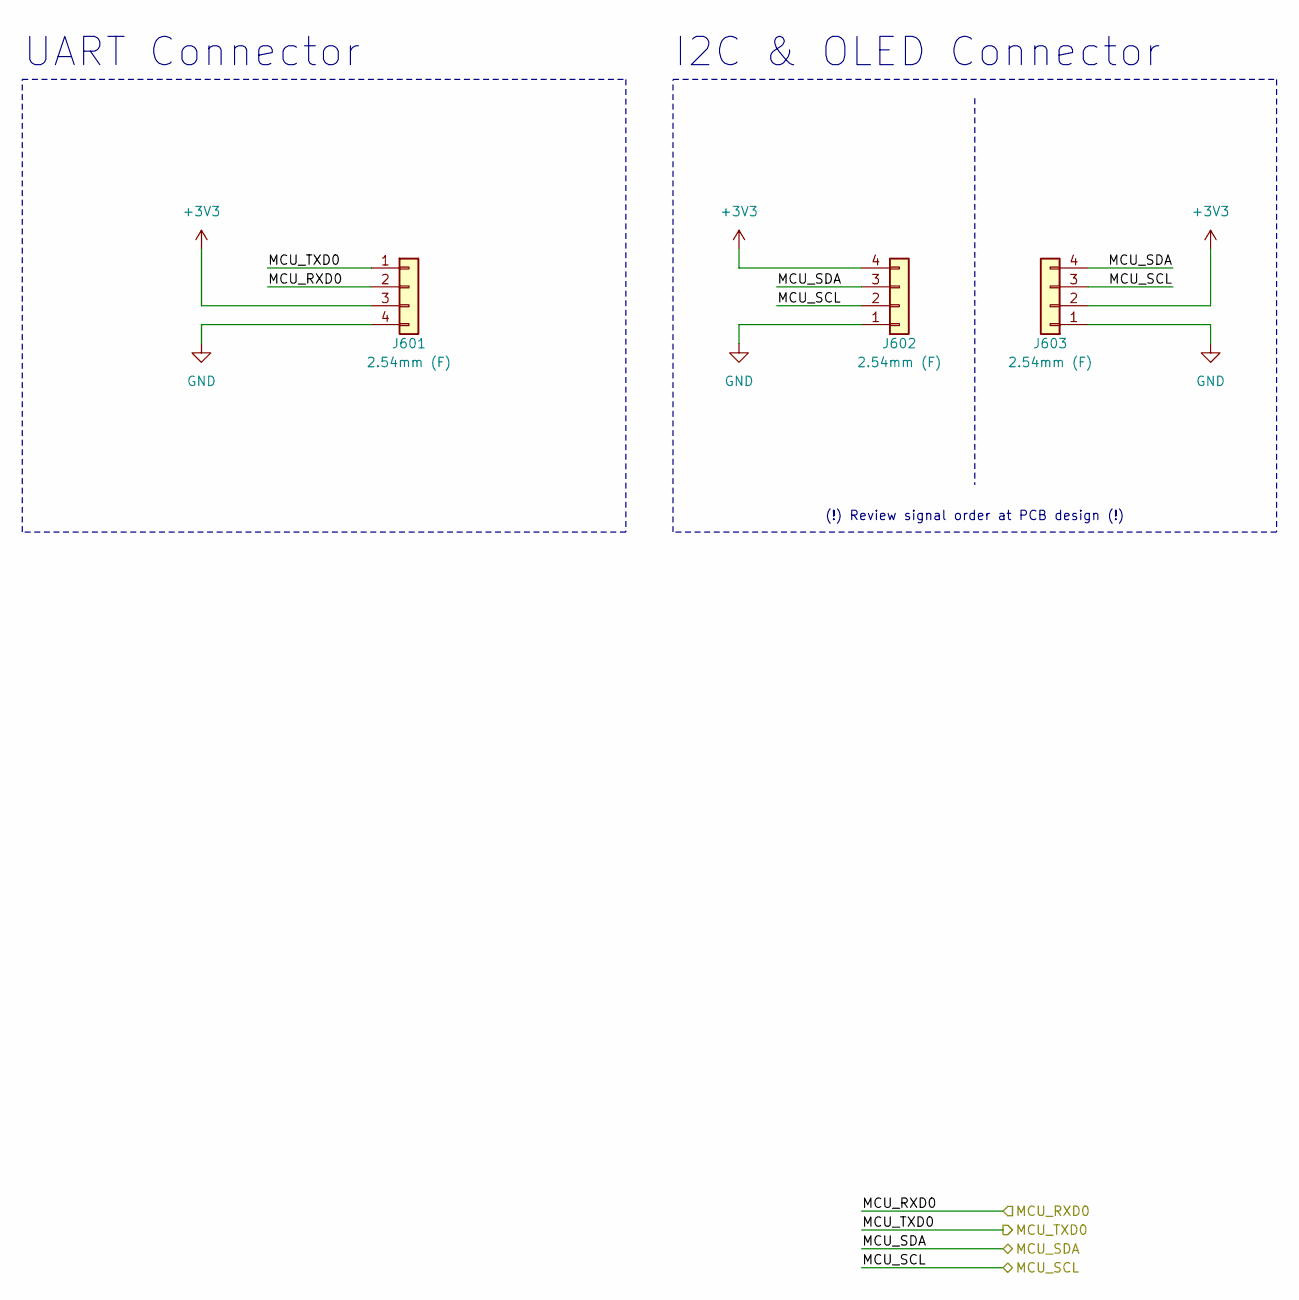
[picture p28: schematic Communication_Interfaces.kicad_sch, LizardBot 1 Control Board: Communication Interfaces]

Parts:
J601, J602, J603: 2.54mm (F); PinHeader_1x04_P2.54mm_Vertical

Connections:
+3V3: J601.3, J602.4, J603.2; also elsewhere on the board
/Communication_Interfaces/MCU_RXD0: J601.2; also elsewhere on the board
/Communication_Interfaces/MCU_SCL: J602.2, J603.3; also elsewhere on the board
/Communication_Interfaces/MCU_SDA: J602.3, J603.4; also elsewhere on the board
/Communication_Interfaces/MCU_TXD0: J601.1; also elsewhere on the board
GND: J601.4, J602.1, J603.1; also elsewhere on the board

Notes on the sheet:
UART Connector
(!) Review signal order at PCB design (!)
I2C & OLED Connector
