lizard-electronics/LizardBot1_ProjectFiles/1_Hardware/PCB/LizardBot1_ControlBoard_v1/LizardBot1_ControlBoard_v1.kicad_pcb

## KiCad design 1_Hardware/PCB/LizardBot1_ControlBoard_v1/LizardBot1_ControlBoard_v1.kicad_pcb (continued)

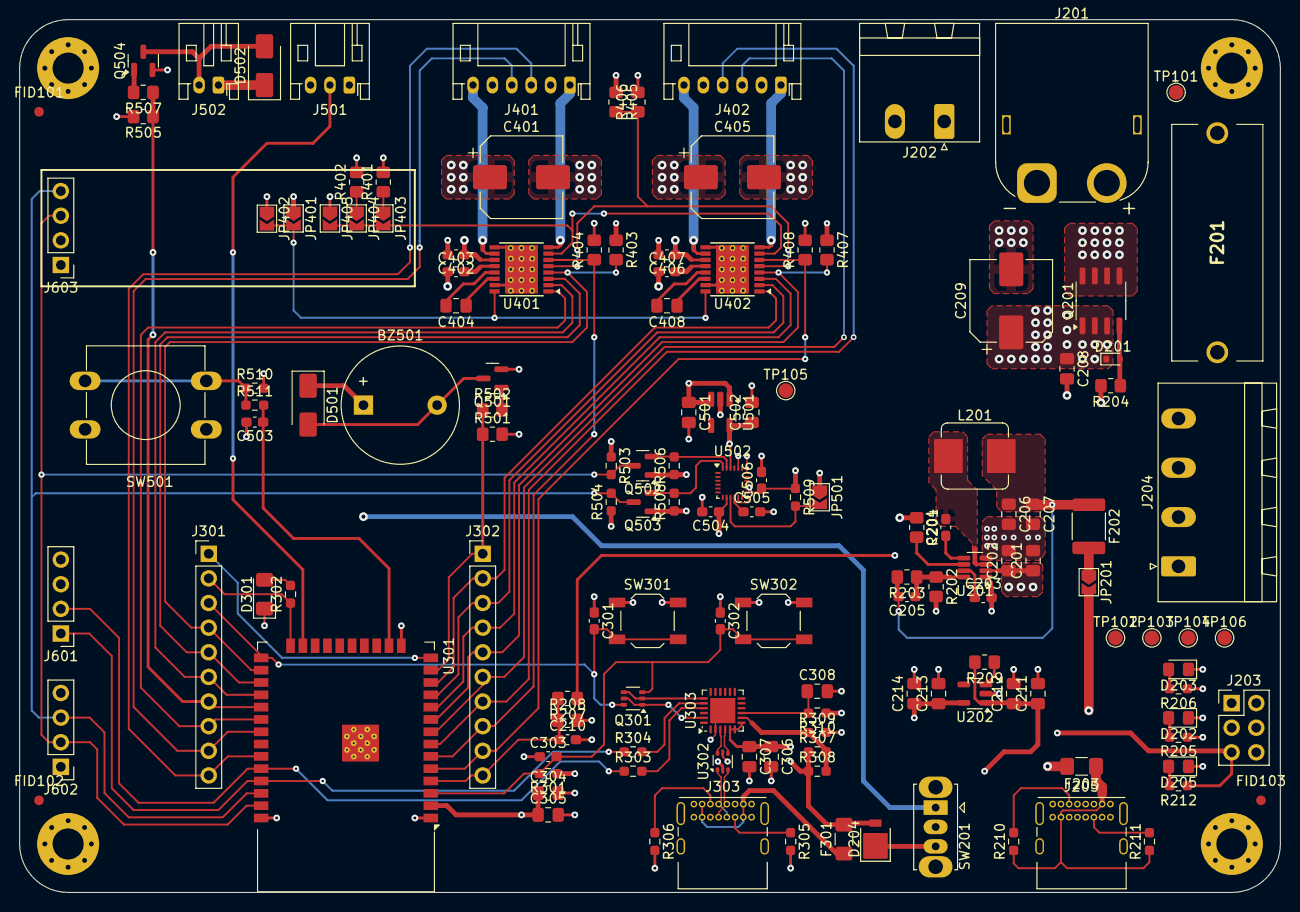
[picture p29: board LizardBot1_ControlBoard_v1.kicad_pcb from above]

Board: 4 copper layers, 130.0 x 90.0 mm, 145 parts (0 on the bottom side), 92 nets.
