lizard-electronics/LizardBot1_ProjectFiles/(commit log)

2024-04-20 Added 1_Hardware files
    [Communication_Interfaces.kicad_sch, Inputs.kicad_sch, LizardBot1_ControlBoard_v1.kicad_pcb, LizardBot1_ControlBoard_v1.kicad_sch, MCU.kicad_sch, Motor_Driver.kicad_sch, Outputs.kicad_sch, Power_Supply.kicad_sch]
2024-06-19 Updated Electrical Layout Block Diagram. Added Power_Supply schematic last changes.
    [Communication_Interfaces.kicad_sch, Inputs.kicad_sch, LizardBot1_ControlBoard_v1.kicad_sch, MCU.kicad_sch, Motor_Driver.kicad_sch, Outputs.kicad_sch, Power_Supply.kicad_sch]
2024-06-25 Added Motor_Driver schematic.
    [Communication_Interfaces.kicad_sch, Inputs.kicad_sch, LizardBot1_ControlBoard_v1.kicad_sch, MCU.kicad_sch, Motor_Driver.kicad_sch, Outputs.kicad_sch, Power_Supply.kicad_sch]
2024-07-02 Added MCU schematic
    [Communication_Interfaces.kicad_sch, Inputs.kicad_sch, LizardBot1_ControlBoard_v1.kicad_sch, LizardBot1_ESP32_Pinout.ods, Outputs.kicad_sch, Power_Supply.kicad_sch]
2024-07-03 Added Peripherals schematic
    [Inputs.kicad_sch, LizardBot1_ControlBoard_v1.kicad_sch, MCU.kicad_sch, Motor_Driver.kicad_sch, Outputs.kicad_sch, Peripherals.kicad_sch, Power_Supply.kicad_sch]
2024-07-04 Added Communication_Interfaces schematic
    [Communication_Interfaces.kicad_sch, LizardBot1_ControlBoard_v1.kicad_sch, MCU.kicad_sch, Motor_Driver.kicad_sch, Peripherals.kicad_sch, Power_Supply.kicad_sch]
2024-07-08 PCB schematics revision
    [Communication_Interfaces.kicad_sch, LizardBot1_ControlBoard_v1.kicad_sch, MCU.kicad_sch, Motor_Driver.kicad_sch, Peripherals.kicad_sch, Power_Supply.kicad_sch]
2024-07-09 Updated schematics. Assigned footprints. Added BOM to /4_Docs.
    [Communication_Interfaces.kicad_sch, LizardBot1_ControlBoard_BOMExport_v1.csv, LizardBot1_ControlBoard_v1.kicad_sch, MCU.kicad_sch, Motor_Driver.kicad_sch, Peripherals.kicad_sch, Power_Supply.kicad_sch]
2024-07-15 Added PCB Stack and Design Rules. Added PCB Layout file.
    [LizardBot1_ControlBoard_BOM.xlsx, LizardBot1_ControlBoard_BOMExport_v1.csv, LizardBot1_ControlBoard_v1.kicad_pcb, LizardBot1_ControlBoard_v1.kicad_sch, LizardBot1_ESP32_Pinout.ods, LizardBot1_ESP32_Pinout.xlsx, Peripherals.kicad_sch, Power_Supply.kicad_sch]
2024-07-31 Finished PCB routing. Updated ESP32 GPIO layout.
    [Bourns_SRP7028AA.STEP, Fuse_1812.STEP, LittelFuse_0PTF0078P.stp, LizardBot1_ControlBoard_BOM.xlsx, LizardBot1_ControlBoard_v1.kicad_pcb, LizardBot1_ControlBoard_v1.kicad_sch, LizardBot1_ESP32_Pinout.xlsx, MCU.kicad_sch]
2024-08-09 Finished robot controller PCB. Generated production files.
    [Communication_Interfaces.kicad_sch, LCSC_Exported__20240809_193047.csv, LizardBot1_ControlBoard_BOM.xlsx, bom.csv, designators.csv, positions.csv]
2024-08-15 Added PCB 3D model & PCB layer view files.
2024-08-27 Updated BOM.
    [LCSC_Exported__20240809_193047.csv, LizardBot1_ControlBoard_BOM.xlsx, LizardBot1_ControlBoard_BOMExport_v1.csv]
2024-09-06 Added ControlBoard firmware to test motor drivers.
2024-09-09 Started Control Board firmware development.
